jjah0001/Momowo/enclosure/Momowo_Backside.step

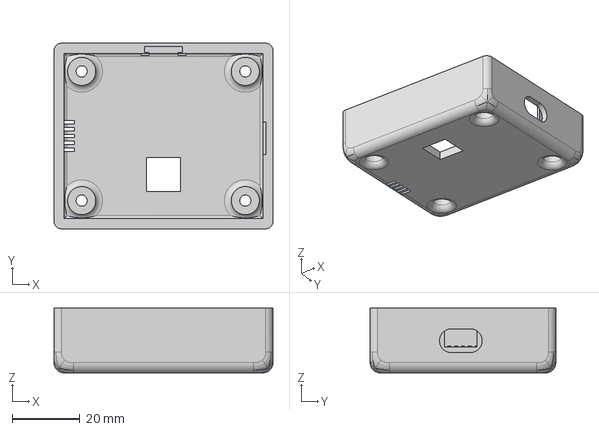
[picture p1: CAD file, 2026-10-25]
enclosure/Momowo_Backside.step
64.6 x 54.7 x 19.1 mm
