jjah0001/Momowo/enclosure/Momowo_Front.step

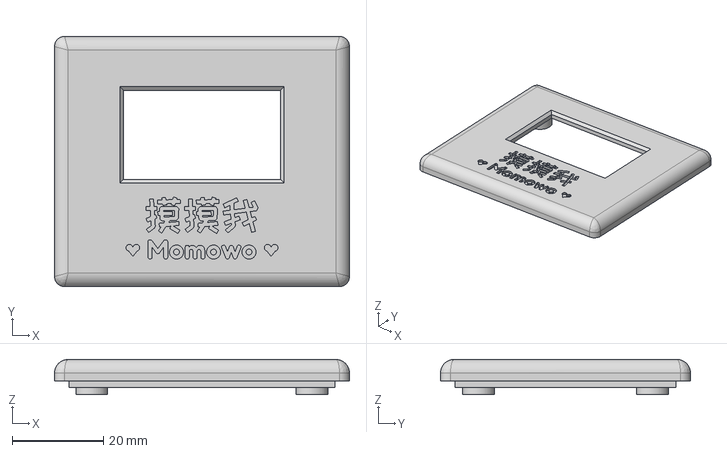
[picture p2: CAD file, 2026-10-25]
enclosure/Momowo_Front.step
64.6 x 54.7 x 7.70 mm
