jjah0001/Momowo/(list of files, cad)

Other CAD files:
enclosure/Momowo_Backside.f3d
enclosure/Momowo_Backside.stl
enclosure/Momowo_Front.f3d
enclosure/Momowo_Front.stl
