jjah0001/Momowo/Momowo_V2.ino

/*
  =====================================================================
   Momowo 摸摸我 ("pat me")  -  ESP32 / ESP32-C3 + TTP223 + SH1106 1.3" OLED + buzzer
  =====================================================================
   An animated desk companion that helps you relax, and also does real work:

     BUDDY    Expressive animated eyes (blinks, looks around, moods, hearts when patted,
              dizzy when shaken) + a ticker: greeting, feelings, time, weather, next prayer
     CLOCK    Big clock, seconds, date; time zone follows where you are
     CALENDAR Gregorian month and the public holidays where you are, plus the calendars you
              choose: Chinese lunar (solar terms, festivals), Islamic (Hijri), Buddhist, Hindu
     WEATHER  Now, tomorrow, the next three days, sunrise and sunset; with the Islamic
              calendar on: prayer times, and imsak / iftar times for fasting
     NEWS     Headlines from any RSS feed; AI reporter sums up the news, can translate it
     QUOTE    Classical Chinese, European or modern quotes; AI translates or explains
     FOCUS    Pomodoro timer with breaks, and a guided breathing exercise
     AI       Optional AI: feelings, translations, summaries, quote meanings
     MOTION   Optional MPU6050: pat or tap the case, shake, tilt, catch a drop
     SOUND    Buzzer: chirps, focus alerts, hourly chime, prayer reminders

   One touch pad does everything:
     tap          -> next page
     double tap   -> back to buddy (he's happy to see you)
     hold ~0.7 s  -> page action (pat buddy / 12-24h / refresh / start-pause)
     hold ~2 s    -> focus page: reset the timer, or start breathing when idle

   Night mode: after SLEEP_HOUR the buddy dozes (Zzz), screen dims, then
   switches off after 10 idle minutes to protect the OLED. Touch wakes it.

   Libraries (Library Manager):
     Adafruit SH110X, Adafruit GFX, ArduinoJson (v7), U8g2_for_Adafruit_GFX
     (the MPU6050 needs no library: motion.h talks to it directly)
   OFFLINE  Works out of the box with no WiFi: buddy, focus timer, clock, calendars and
            built-in classical quotes. Hold the pad 6 s, scan the QR code with a phone,
            and the page that opens sets the clock from the phone (no internet needed)
            and, optionally, WiFi for weather, news and AI.
   RTC      Optional DS3231 clock module on the same I2C pins keeps time through power cuts.
   MOTION   Optional MPU6050 on the same I2C pins. With a DS3231 too, tie the MPU6050's AD0
            pin to 3V3 so it moves to address 0x69.
   Board: ESP32 dev board, or ESP32-C3 SuperMini (pins below switch automatically)
   Tools > Partition Scheme > "Huge APP (3MB No OTA/1MB SPIFFS)". Arduino-ESP32 core 3.x.
   Saved settings are kept when you change partition scheme.
  =====================================================================
*/

#include <WiFi.h>
#include <WiFiClientSecure.h>
#include <HTTPClient.h>
#include <ArduinoJson.h>
#include <Wire.h>
#include <Adafruit_GFX.h>
#include <Adafruit_SH110X.h>
#include <U8g2_for_Adafruit_GFX.h>
#include "font_tc.h"                         // Traditional Chinese font (Fusion Pixel, OFL)
#include <time.h>
#include <math.h>
#include <Preferences.h>
#include <WebServer.h>
#include <DNSServer.h>
#include <ESPmDNS.h>
#include "qrcode.h"                       // Espressif QR encoder (part of core 3.x)
#include "astro.h"                        // sun, moon, prayer times, Hindu calendar
#include "motion.h"                       // MPU6050 driver and gestures
#include "quotes.h"                       // European and modern quotes
#include "games.h"                        // the mini-games page for the phone
#include "font_small.h"                   // tiny 8 px weekday letters for the month grid

// ============================ SETTINGS ===============================
// Owners change these from their phone (setup page); nothing here needs editing.
// The values below are only the starting defaults; saved settings replace them.
static char WIFI_SSID[33]  = "";          // home WiFi (empty = setup mode on first start)
static char WIFI_PASS[65]  = "";
static char WIFI2_SSID[33] = "";          // backup WiFi, e.g. a phone hotspot
static char WIFI2_PASS[65] = "";
static char OWNER_NAME[24] = "";          // used in greetings
static char OWNER_HOBBIES[128] = "";      // owner's hobbies, for more personal AI feelings
static uint8_t OWNER_GENDER = 0;          // 0 not said, 1 male, 2 female, 3 other: for the AI's wording
static uint8_t LANG = 0;                   // Momowo's language (Lang), chosen on the phone page

// Weather location: a suburb or area name, e.g. "Tampines", searched in COUNTRY_CODE.
// Empty = use the IP lookup below (city-level only).
static char SUBURB[64]      = "";
static char COUNTRY_CODE[4] = "SG";

// Location is looked up automatically from your public IP (city-level).
// Set USE_IP_LOCATION = false to always use the fixed spot below instead.
// The fixed spot is also the fallback if the IP lookup keeps failing.
static const bool  USE_IP_LOCATION = true;
static const float FIXED_LAT  = 1.3521f;
static const float FIXED_LON  = 103.8198f;
static const char* FIXED_CITY = "Singapore";

// Timezone is learned automatically (IP lookup + Open-Meteo, DST included).
// This string is only used until the first successful lookup.
static const char* FALLBACK_TZ = "SGT-8";     // Singapore, UTC+8, no daylight saving

static bool USE_24H = true;             // hold on CLOCK page toggles this (remembered)
static const bool HIJRI_AT_SUNSET = false; // true: Islamic date turns over at sunset, not midnight
static int SLEEP_HOUR = 22;             // buddy dozes off (10 pm)
static int WAKE_HOUR  = 7;              // buddy wakes up
static uint8_t FOCUS_MIN = 25;          // Pomodoro length (minutes), set on the phone page
static uint8_t BREAK_MIN = 5;           // short break; every 4th break is three times longer

// Wake-up alarm: up to three alarm times (phone page), plus a nap timer on the Alarm page
#define ALARM_SLOTS 3
struct AlarmSlot { uint8_t h = 7, m = 0, days = 0x3E, on = 0; };   // days: bit 0 Sunday .. bit 6 Saturday, 0 = once
static AlarmSlot ALARMS[ALARM_SLOTS];
static bool    ALARM_ON   = true;       // all alarms on or off (hold on the Alarm page)
static uint8_t SNOOZE_MIN = 9;          // a tap snoozes this long; 0 = no snooze
static uint8_t ALARM_STOP = 0;          // stop by: 0 holding the pad 2 s, 1 shaking Momowo 3 times
static uint8_t NAP_MIN    = 20;         // the nap timer (hold 2 s on the Alarm page)

// Calendars shown beside the Gregorian one (phone page), and what the Islamic one brings
enum : uint8_t { CAL_CHINESE = 1, CAL_ISLAMIC = 2, CAL_BUDDHIST = 4, CAL_HINDU = 8, CAL_JEWISH = 16, CAL_ALL = 31 };
static uint8_t CALS = CAL_CHINESE;
static uint8_t PRAY_METHOD = 255;       // astro::METHODS index; 255 = automatic for the country
static bool    ASR_HANAFI  = false;     // Asr when shadows are twice an object's length
static bool    PRAY_REMIND = true;      // a soft chime and a note at each prayer time

// Quotes: one bit per source, any mix (QKind order): classical Chinese, European, modern,
// Bible, Quran, Torah, Dhammapada, famous people. Momowo takes turns. AI: 0 translate, 1 explain
static uint16_t QUOTE_MASK = 1;
static uint8_t QUOTE_AI  = 0;
static char FAMOUS_PEOPLE[100] = "";    // the owner's own famous people: the AI picks their real quotes

static bool    NEWS_TRANSLATE = false;  // AI translates the headlines into Momowo's language
static uint8_t NEWS_STYLE     = 0;      // AI summary: 0 one sentence, 1 a short news-of-the-day bulletin

static bool    MOTION_ON     = true;    // MPU6050 gestures, if one is fitted
static uint8_t MOTION_SENS   = 2;       // 1 gentle .. 3 sensitive
static bool    MOTION_MIRROR = false;   // eyes look the wrong way when tilted? flip them

// Buzzer on GPIO27. Passive buzzers play tunes; active ones can only beep.
static const bool    BUZZER_PASSIVE   = true;
static uint8_t       NEWS_VOICE       = 0;      // AI news reporter, chosen on the phone page (see VOICES; 6 = own)
static char NEWS_VOICE_OWN[64] = "";       // the owner's own reporter, described on the phone page
static bool          TOUCH_CLICK      = true;   // tiny tick on every touch
static bool          HOURLY_CHIME     = true;   // double beep on the hour, daytime only
static const int QUOTE_MAX_CHARS = 12;    // classical quote length limit (punctuation counts)
static const bool QUOTE_FOLLOWS_CONTEXT = true;   // match season, weather and time of day

// News: any RSS feed. BBC News top stories by default (credited on screen).
static char NEWS_FEED_URL[160] = "https://www.channelnewsasia.com/api/v1/rss-outbound-feed?_format=xml&category=6311";
static char NEWS_CREDIT[32]     = "CNA";

// Optional AI: one active provider, with independent saved keys and model overrides.
// Provider 0 preserves existing Claude settings and the legacy "aikey" preference.
static uint8_t AI_PROVIDER = 0;
static char AI_API_KEY[512] = "";
static char AI_MODEL_CUSTOM[96] = "";
static const char* const AI_KEY_PREFS[] = {"aikey", "openai_key", "kimi_key", "deepseek_key"};
static const char* const AI_MODEL_PREFS[] = {"claude_model", "openai_model", "kimi_model", "deepseek_model"};
static const char* const AI_DEFAULT_MODELS[] = {"", "gpt-4.1-mini", "kimi-k2.6", "deepseek-flash"};
static const char* const AI_ENDPOINTS[] = {
  "https://api.anthropic.com/v1/messages",
  "https://api.openai.com/v1/chat/completions",
  "https://api.moonshot.ai/v1/chat/completions",
  "https://api.deepseek.com/chat/completions"
};
// Model and effort are chosen on the phone page. Smarter models and more effort cost more and take longer.
static const char* const AI_MODELS[4]  = {"claude-haiku-5-5", "claude-sonnet-5-5", "claude-opus-5-5", "claude-fable-5-1"};
static const char* const AI_EFFORTS[5] = {"low", "medium", "high", "xhigh", "max"};
static const int         AI_THINK_ROOM[5] = {2000, 4000, 8000, 16000, 32000};   // tokens for thinking, on top of the reply
static uint8_t     AI_MODEL_IX          = 0;     // Haiku
static uint8_t     AI_EFFORT_IX         = 0;     // low: short texts don't need long thinking
static uint16_t    AI_DAY_LIMIT         = 100;   // safety cap on cost: requests a day, chosen on the phone page
static volatile uint16_t gAiUsed        = 0;     // today's requests, kept in flash so a restart doesn't reset them
static int16_t     gAiDay               = -1;    // the day they were counted (day of the year)
static uint16_t    FEEL_MIN             = 90;    // with AI: a feeling of its own every this many minutes (0 = off), chosen on the phone page
#define AI_FEELINGS (FEEL_MIN > 0)

// The AI reply arrives streamed (server-sent events). Streaming keeps the connection busy while the
// model thinks, so high effort doesn't time out; only the reply's text is kept.
class SseSink : public Stream {
 public:
  SseSink(char* o, size_t n) : out(o), outSz(n) { out[0] = 0; }
  char* out;
  size_t outSz, len = 0;
  char stop[20] = "";                       // stop_reason: end_turn, max_tokens, refusal...
  bool error = false;
  size_t write(uint8_t c) override {
    if (c == '\n') {
      if (!skip) { line[ll] = 0; take(); }
      ll = 0;
      skip = false;
    } else if (c != '\r') {
      if (ll + 1 < sizeof(line)) line[ll++] = c;
      else {
        line[ll] = 0;
        skip = true;
        // Claude signatures/thinking can exceed the line buffer; no display text is lost.
        if (!strstr(line, "\"signature_delta\"") && !strstr(line, "\"thinking_delta\"")) error = true;
      }
    }
    return 1;
  }
  size_t write(const uint8_t* b, size_t n) override { for (size_t i = 0; i < n; i++) write(b[i]); return n; }
  int available() override { return 0; }
  int read() override { return -1; }
  int peek() override { return -1; }
  void flush() override {}
 private:
  char line[1024];
  size_t ll = 0;
  bool skip = false;
  void take() {
    if (strncmp(line, "data:", 5)) return;
    const char* j = line + 5;
    while (*j == ' ') ++j;
    if (!strcmp(j, "[DONE]")) return;
    JsonDocument d;
    if (deserializeJson(d, j)) { error = true; return; }
    const char* type = d["type"] | "";
    if (!strcmp(type, "error") || !d["error"].isNull()) { error = true; return; }
    const char* text = "";
    if (!strcmp(type, "content_block_delta") &&
        !strcmp(d["delta"]["type"] | "", "text_delta")) text = d["delta"]["text"] | "";
    if (!strcmp(type, "message_delta"))
      strlcpy(stop, d["delta"]["stop_reason"] | "", sizeof(stop));
    if (d["choices"].is<JsonArray>() && d["choices"].size()) {
      text = d["choices"][0]["delta"]["content"] | "";
      if (!d["choices"][0]["delta"]["refusal"].isNull()) error = true;
      if (d["choices"][0]["finish_reason"].is<const char*>())
        strlcpy(stop, d["choices"][0]["finish_reason"], sizeof(stop));
    }
    size_t n = strlen(text);
    if (n >= outSz - len) n = outSz - 1 - len;
    memcpy(out + len, text, n);
    len += n;
    out[len] = 0;
  }
};

// ============================ HARDWARE ===============================
#if CONFIG_IDF_TARGET_ESP32C3    // ESP32-C3 SuperMini: matches PCB: SDA GPIO9, SCL GPIO8 (both strapping pins)
#define TOUCH_PIN  3
#define BUZZER_PIN 4
#define OLED_SDA   9
#define OLED_SCL   8
#else                            // classic ESP32 dev board
#define TOUCH_PIN  12    // NOTE: GPIO12 is a boot strapping pin, must be LOW at power-up
#define BUZZER_PIN 27
#define OLED_SDA   21
#define OLED_SCL   22
#endif

#if CONFIG_FREERTOS_UNICORE      // single-core chips (ESP32-C3): everything on core 0
#define NET_CORE 0
#define SND_CORE 0
#else                            // dual-core ESP32: network on core 0, sound beside loop()
#define NET_CORE 0
#define SND_CORE 1
#endif
#define OLED_ADDR  0x3C
#define SCREEN_W   128
#define SCREEN_H   64

Adafruit_SH1106G display(SCREEN_W, SCREEN_H, &Wire, -1);

static const uint8_t CONTRAST_DAY   = 0x80;   // 0x00-0xFF
static const uint8_t CONTRAST_NIGHT = 0x01;   // dimmed while buddy sleeps
static const uint8_t CONTRAST_IDLE  = 0x20;   // daytime, nobody near for 20 min (saves the OLED)
static const uint8_t CONTRAST_QR    = 0x30;   // setup QR code: a dimmer white square doesn't glare in phone cameras

U8G2_FOR_ADAFRUIT_GFX u8f;                    // draws UTF-8 Chinese into the same buffer
// One 14 px subset font (common GB2312 hanzi) for the quote and its source,
// so the sketch fits the default partition scheme on ESP32 core 3.x. Quotes
// using a character outside it are skipped, so nothing shows as a gap.
// With Tools > Partition Scheme > Huge APP you could use larger, full fonts,
// e.g. u8g2_font_wqy16_t_gb2312 for the quote and wqy12_t_gb2312 for the source.
#define CJK_FONT     u8g2_font_wqy14_t_gb2312b  // quote source line
#define CJK_FONT_BIG u8g2_font_wqy14_t_gb2312b  // the quote itself

#define DEG "\xF8"   // degree symbol in CP437 font

// ============================ TIMING =================================
static const uint32_t FRAME_MS         = 33;              // ~30 fps
static const uint32_t LONG_MS          = 700;
static const uint32_t VLONG_MS         = 2000;
static const uint32_t SETUP_HOLD_MS    = 6000;   // hold this long anywhere: setup mode
static const uint32_t DOUBLE_GAP_MS    = 300;
static const uint32_t IDLE_HOME_MS     = 90000;           // return to buddy
static const uint32_t WEATHER_EVERY_MS = 15UL * 60 * 1000;
static const uint32_t GEO_EVERY_MS     = 6UL * 60 * 60 * 1000;   // re-check if you travel
static const uint32_t HOME_CHECK_MS    = 10UL * 60 * 1000;       // on hotspot: look for home WiFi
static const uint32_t QUOTE_MIN_GAP_MS = 30UL * 60 * 1000;       // context change -> new quote, at most this often
static const uint32_t NEWS_EVERY_MS    = 30UL * 60 * 1000;       // headlines refresh
static const uint32_t BRIEF_EVERY_MS   = 2UL * 60 * 60 * 1000;   // AI news briefing refresh
#define FEEL_EVERY_MS ((uint32_t)FEEL_MIN * 60000UL)                   // AI feeling, waking hours only
static const uint32_t NIGHT_OFF_MS     = 10UL * 60 * 1000;
#define focusMs() (FOCUS_MIN * 60UL * 1000)   // a macro: a function here would come before the types below

// ============================ SHARED DATA ============================
struct WeatherData {
  bool valid = false;
  uint32_t at = 0;                          // millis() when it was fetched
  float temp = 0, feels = 0, tmax = 0, tmin = 0, wind = 0;
  int humidity = 0, code = 0, rainChance = 0;
  bool isDay = true;
  int sunriseMin = -1, sunsetMin = -1;      // today, minutes after midnight
  int tmSunrise = -1, tmSunset = -1;        // tomorrow
  bool tmValid = false;     // tomorrow's forecast
  float tmMax = 0, tmMin = 0, tmWind = 0;
  int tmCode = 0, tmRain = 0;
  uint8_t days = 0;         // daily forecast: 0 today, 1 tomorrow, 2-4 the next three days
  int8_t dMax[5], dMin[5];
  uint8_t dCode[5], dRain[5];
  int aqi = -1;             // US Air Quality Index now (-1 unknown), and particles in ug/m3
  float pm25 = -1, pm10 = -1;
};

enum QKind : uint8_t { Q_CHINESE, Q_EUROPE, Q_MODERN, Q_BIBLE, Q_QURAN, Q_TORAH, Q_DHAMMA, Q_FAMOUS, Q_KINDS };
struct QuoteData {
  QKind kind = Q_CHINESE;
  char text[256] = "";      // raw UTF-8, in the original language
  char author[96] = "";
  char tag[8] = "";         // theme shown beside the source, e.g. "雨"
  char meaning[320] = "";   // meaning, translation or explanation (AI or built-in), UTF-8
  int8_t lang = -1;         // famous people: the quote's language (Lang), -1 another one
  uint32_t version = 0;
};

#define NEWS_MAX 8
struct NewsData {
  uint8_t count = 0;
  char title[NEWS_MAX][120];   // headlines, UTF-8 (translated by the AI if asked)
  char brief[640] = "";        // AI briefing: one sentence, or a short bulletin
  uint32_t version = 0;
};

struct LocationData {
  bool valid = false;
  float lat = 0, lon = 0;
  char city[40] = "";                       // English (plain ASCII): for the AI prompts
  char name[64] = "";                       // in the chosen language (UTF-8): shown on screen
};

static WeatherData gWeather;
static QuoteData gQuote;
static LocationData gLoc;

struct CalInfo {                            // today's date in the three calendars
  bool valid = false;
  bool lunarOk = false, leap = false, eve = false;   // eve = Chinese New Year's Eve
  int ly = 0, lm = 0, ld = 0;               // Chinese lunar year / month / day
  int termToday = -1, termNext = -1, termDays = 0;   // solar terms
  int be = 0;                               // Buddhist year (Indonesian: new year at Waisak)
  bool waisak = false;
  const char* christian = nullptr;          // Christmas / Easter day name, English
  int hy = 0, hm = 0, hd = 0;               // Hijri year / month / day
  int wday = 0;
  bool hinduOk = false;                     // Hindu calendar (needs a location for sunrise)
  astro::Panchang pj;
  const char* hinduFest = nullptr;
  bool hebOk = false;                       // Hebrew date (from sunset), festival, Shabbat
  int32_t hebY = 0;
  int hebM = 0, hebD = 0, hebFestN = 0;
  astro::HebFest hebFest = astro::HF_NONE;
  int candles = -1;                         // Friday: Shabbat candle lighting, minutes after midnight
  bool shabbat = false;
  char holToday[48] = "";                   // today's public holiday, if any
  char holNext[48] = "";                    // the next one this year, in holDays days
  int holDays = -1;
  uint32_t holMask = 0;                     // bit d: day d of this month is a public holiday
};

struct PrayerDay {                          // today's prayer times, minutes after midnight
  bool valid = false;
  int key = -1;
  float t[astro::PRAYER_COUNT];
  float tmFajr = NAN;                       // tomorrow's, for the evening countdown
};

struct LunarDay { uint8_t m, d; const char* label; const char* greeting; };
struct Note { uint16_t hz; uint16_t ms; };       // hz 0 = rest

static CalInfo gCal;

// Public holidays in the country Momowo is in (Nager.Date), nationwide ones only.
// Written by the network task, kept through restarts.
struct Holiday { uint8_t m, d; char name[48]; };
static const int HOL_MAX = 28;
static Holiday gHol[HOL_MAX];
static uint8_t gHolCount = 0;
static int16_t gHolYear = 0;
static char gHolCC[4] = "";
static uint8_t gHolLang = 255;
static volatile uint16_t gHolVersion = 0;
static char gHolGreet[96];
static char gHebGreet[96];
static int8_t gHijriAdj = 0;                // -1, 0, +1 days (hold on CALENDAR)
static bool gMuted = false;                 // set on the phone settings page (remembered)
static Preferences prefs;
static SemaphoreHandle_t gMutex;
static SemaphoreHandle_t gScanMutex;        // one WiFi scan at a time: both cores share the scan list
static volatile bool gWifiUp = false;
static volatile bool gOnHotspot = false;   // on the backup network
static volatile bool gEverOnline = false;
static volatile bool gSetupMode = false;   // Momowo's own WiFi + setup page
static volatile uint8_t gWifiReason = 0;   // why the last WiFi connection failed (0 = fine)
static bool gSetupAuto = false;            // opened because home WiFi kept failing
static char gApSsid[16], gApPass[12];
static char gHost[20] = "momowo";          // unique per unit, e.g. momowo-a1b2 (many units, one network)
static uint32_t gSetupAt = 0;              // when setup mode opened
static float gSavedLat = NAN;              // last known latitude, for seasons while offline
static float gSavedLon = NAN;              // and longitude, for prayer times offline
static PrayerDay gPray;
static uint8_t gBreaks = 0;                 // breaks taken this session run, for the long break
static bool gMotion = false;                // MPU6050 found
static motion::State gMs;
static int gShakesToday = 0, gBreathsToday = 0;
static char gCountryCode[4] = "";           // from the IP lookup, e.g. "SG" (picks the prayer method)
static bool gRtc = false;                  // DS3231 clock module found
static volatile uint32_t gRestartAt = 0;
static volatile uint32_t gNetAlive = 0;     // netTask's last pass
static volatile bool gRestartSoon = false;  // memory is getting fragmented: restart when nobody's looking
static WebServer server(80);
static DNSServer dnsServer;
static volatile bool gReqWeather = false;
static volatile bool gReqQuote = false;
static volatile bool gReqNews = false;
static NewsData gNews;

// Timezone learned from the network (seconds east of UTC); loop() applies it
static volatile int32_t  gTzOffset  = 0;
static volatile bool     gTzKnown   = false;
static volatile uint32_t gTzVersion = 0;
static char gTzRule[48] = "";               // the phone's time zone with its summer-time rule (POSIX TZ), if any
static volatile bool gTzRuleOn = false;      // that rule sets the offset (loop() checks it)
static volatile int32_t gTzSaid = 0;         // the offset the network last reported
static volatile uint32_t gTzSaidVer = 0;

// ============================ UI STATE ===============================
enum Page : uint8_t { P_BUDDY, P_CLOCK, P_CAL, P_WEATHER, P_NEWS, P_QUOTE, P_FOCUS, P_ALARM, P_COUNT };
enum Lang : uint8_t { L_EN, L_ZHS, L_ZHT, L_ID, L_DE, L_FR, L_JA, L_ES, L_COUNT };   // phone page order
#include "lang.h"                           // screen labels in all eight languages: T(S_...)
struct BuddhistDay { uint8_t m, d; Str name; };
enum Mood : uint8_t { M_NORMAL, M_HAPPY, M_SLEEPY, M_SURPRISED, M_LOVE, M_SAD, M_DIZZY };

struct Feeling {                            // Momowo's own feeling (AI), guarded by gMutex
  bool valid = false;
  Mood mood = M_NORMAL;
  char thought[160] = "";                   // first person, UTF-8
  char pats[3][64];                         // replies to a pat while feeling this way
  uint8_t patCount = 0;
  uint32_t version = 0;
};
static Feeling gFeel;
static int gPatsToday = 0;                    // kept in flash with the focus count's date
static uint32_t gFeelSavedAt = 0, gBriefSavedAt = 0;   // when a restored feeling / briefing was made
static int gQuoteRestoredKey = -3;            // context of a quote restored at start-up (-3: none)
enum FocusState : uint8_t { F_IDLE, F_RUN, F_PAUSE, F_BREAK, F_BREATHE };   // break and breathing count down too
enum Gesture : uint8_t { G_NONE, G_TAP, G_DOUBLE, G_LONG, G_VLONG, G_SETUP, G_HINT };
enum WIcon : uint8_t { W_CLEAR, W_PARTLY, W_CLOUD, W_FOG, W_DRIZZLE, W_RAIN, W_SNOW, W_STORM };
enum QTheme : uint8_t { T_SPRING, T_SUMMER, T_AUTUMN, T_WINTER, T_RAIN, T_SNOW, T_CLOUD, T_WIND,
                        T_SUN, T_MOON, T_STARS, T_NONE };
// One line of the "today in each calendar" view. lunar: drawn in the Chinese lunar font.
struct CalRow { char text[72]; char alt[72]; bool lunar; };
struct LocalQuote { QTheme theme; const char* text; const char* who; const char* from; const char* meaning; };
// 今日诗词 v1 category for each quote theme, and the tag shown beside the source
static const char* const THEME_PATH[] = {
  "siji/chuntian", "siji/xiatian", "siji/qiutian", "siji/dongtian",
  "tianqi/xieyu", "tianqi/xiexue", "tianqi/xieyun", "tianqi/xiefeng",
  "tianqi/taiyang", "tianqi/yueliang", "tianqi/xingxing"};
static const char* const THEME_TAG[] = {"春", "夏", "秋", "冬", "雨", "雪", "云", "风", "日", "月", "星"};
// The alarm while it rings, snoozes or times a nap
enum : uint8_t { AL_IDLE, AL_RING, AL_SNOOZE };
struct AlarmNote { uint16_t hz; uint8_t steps; };   // steps: eighth notes
struct AlarmRun {
  uint8_t state = AL_IDLE;
  bool nap = false;                         // this ring ends a nap
  uint8_t h = 0, m = 0;                     // the alarm time it rings for
  uint8_t snoozes = 0, shakes = 0;
  uint32_t ringAt = 0;                      // when this round of ringing began
  uint32_t snoozeUntil = 0, napUntil = 0, napTotal = 0;
  uint32_t pressSeen = 0;                   // a pad press the alarm already used: its gestures are ignored
  uint32_t lastMin = 0;                     // the last minute checked (minutes since 1970)
};
// NOTE: keep every custom type up here. The Arduino IDE inserts function
// prototypes above the first function, so types declared later break them.

static Page gPage = P_BUDDY;
static uint32_t gPageEnter = 0, gLastInteraction = 0, gNightAwakeUntil = 0, gFlashUntil = 0;
static uint32_t gLoopNow = 0;                 // loop()'s "now", for the web handlers it calls
static bool gNight = false, gSleeping = false, gDisplayOn = true, gInverted = false;
static char gAiStatus[64] = "";             // why the last AI request failed, shown on the ticker
static char gNewsStatus[96] = "";           // why the news is missing, shown on the News page

static char gToast[32];
static uint32_t gToastUntil = 0;
static char gTicker[160];                  // big enough for a whole AI feeling, in any language
static uint32_t gTickerStart = 0, gTickerUntil = 0;

static AlarmRun gAlarm;
static volatile uint8_t  gAlarmLevel = 0;   // for the sound task: 0 quiet, 1-3 how insistently the alarm plays
static volatile uint16_t gBuzzDuty = 511;   // buzzer PWM duty (the alarm starts softly)
static FocusState fState = F_IDLE;
static uint32_t fRemain = 25 * 60000UL, fLastTick = 0, fTotal = 25 * 60000UL;   // fTotal: this phase's length
static int gSessions = 0, gSessionDay = -1;  // today's focus sessions and their date (year*1000+day),
                                             // kept in flash so a restart or settings change keeps them

struct Buddy {
  float gx = 0, gy = 0, tgx = 0, tgy = 0;   // gaze (current / target)
  float h = 26;                             // eye height
  uint32_t nextGaze = 0, nextBlink = 0, blinkAt = 0, nextAntic = 0;
  bool doubleBlink = false;
  Mood ov = M_NORMAL;                       // temporary mood override
  uint32_t ovUntil = 0;
  uint32_t heartsAt = 0;                    // little hearts float up after a pat
} B;

// Mini-games, played on the phone page while Momowo plays along on its screen
enum : uint8_t { GM_NONE, GM_RPS, GM_TTT, GM_GUESS, GM_SIMON, GM_ROLL, GM_RIDDLE, GM_QUEST, GM_TAP };
enum : uint8_t { RD_NONE, RD_THINKING, RD_ASKING, RD_JUDGING, RD_SOLVED, RD_REVEALED, RD_FAILED };
enum : uint8_t { QS_NONE, QS_THINKING, QS_READY, QS_STEP, QS_DONE };          // quest phases
enum : uint8_t { TP_IDLE, TP_WAIT, TP_GO, TP_SHOW, TP_DONE };                 // quick tap phases
#define TAP_ROUNDS 5
enum : uint8_t { QA_TAP, QA_HOLD, QA_LEFT, QA_RIGHT, QA_UP, QA_DOWN, QA_SHAKE, QA_COUNT };   // quest actions
#define QUEST_MAX 8
struct Game {
  uint8_t game = GM_NONE;
  uint32_t last = 0, at = 0;                // the phone's last move; when the current show began
  uint32_t rAt = 0;                         // when the riddle text started (its own: the AI answers any time)
  Mood mood = M_NORMAL;                     // Momowo's reaction, until moodUntil
  uint32_t moodUntil = 0;
  Str say = S_GM_YOUR_TURN;                 // what Momowo says (with sayArg for a %d)
  int sayArg = 0;
  bool sounded = true;                      // the reveal sound has played
  int8_t you = -1, me = -1, result = 0;     // rock paper scissors: 0 rock, 1 paper, 2 scissors;
  uint16_t wins = 0, losses = 0;            // result 0 draw, 1 you win, 2 Momowo wins
  uint8_t board[9] = {};                    // tic-tac-toe: 0 empty, 1 you, 2 Momowo
  uint8_t over = 0, lastMove = 255;         // 0 playing, 1 you won, 2 Momowo won, 3 draw
  uint8_t secret = 0, tries = 0, guess = 0; // guess my number
  int8_t hint = 0;                          // 1 higher, -1 lower, 2 right
  uint8_t seq[40] = {}, len = 0, pos = 0, best = 0;   // memory: arrows up, right, down, left
  bool showing = false;
  uint8_t shown = 255, pressed = 255;       // the arrow lit by the show, and by the owner
  uint32_t pressedAt = 0;
  // star roll: tilt Momowo to roll the ball onto the stars (pixels, pixels per second)
  float bx = 64, by = 40, vx = 0, vy = 0, cx = 20, cy = 30, cvx = 16, cvy = 9;
  int16_t sx = 0, sy = 0;
  uint16_t stars = 0, bestStars = 0;
  bool rolling = false, newBest = false;
  uint32_t startAt = 0, endAt = 0, tickAt = 0, hurtAt = 0, starAt = 0;
  // riddles: the AI makes one up and judges guesses that don't match its answer exactly
  uint8_t rphase = RD_NONE, rtries = 0;
  bool rhint = false;
  char riddle[240] = "", answer[48] = "", alts[160] = "", hintText[120] = "", rguess[48] = "";
  // quest: the AI tells a little adventure; each moment asks for a tap, a hold, a tilt or a shake
  uint8_t qphase = QS_NONE, qn = 0, qstep = 0, qhearts = 0, qscore = 0, qbest = 0;
  uint8_t qact[QUEST_MAX] = {};
  bool qwon = false, qnewBest = false, qarmed = false, qok = false, qstory = false;
  uint32_t qreadyAt = 0, qstepAt = 0, qwin = 0, qwaitUntil = 0;
  float holdRef[3] = {0, 0, 1};             // star roll, quest: how the player holds Momowo; tilts count from here
  char qtitle[64] = "", qtext[QUEST_MAX][100] = {}, qend[2][120] = {};   // ending: 0 won, 1 lost
  // quick tap: wait for the flash and the beep, then tap the pad; the average of 5 rounds counts
  uint8_t tphase = TP_IDLE, tround = 0;
  int16_t tlast = 0;                        // last round: ms, -1 too soon, -2 too slow
  uint16_t tms[TAP_ROUNDS] = {}, tavg = 0, tbest = 0;   // best: lowest average, ms
  bool tnewBest = false;
  uint32_t tgoAt = 0, tfakeAt = 0, tshowUntil = 0, tseen = 0;
} gGame;
static bool gAiForUser = false;            // netTask: this AI request was asked for just now (riddles)
static volatile uint8_t gRiddleReq = 0;     // for netTask: 1 make a riddle, 2 judge the guess
static volatile bool gQuestReq = false;     // for netTask: write a quest story
static uint32_t gTouchPressAt = 0;          // when the finger last went down on the pad
static uint32_t gLastTouch = 0;             // the pad was last touched (its bumps are not pats)

// ============================ HELPERS ================================
static bool nowTm(struct tm& t) {
  time_t n = time(nullptr);
  if (n < 1700000000) return false;         // not synced yet
  localtime_r(&n, &t);
  return true;
}

static bool isNightHour(int h) {
  return SLEEP_HOUR > WAKE_HOUR ? (h >= SLEEP_HOUR || h < WAKE_HOUR)
                                : (h >= SLEEP_HOUR && h < WAKE_HOUR);
}

// Language names for the AI, and the words Momowo says itself (same order as Lang)
static const char* const LANG_NAME[L_COUNT] = {"English", "Simplified Chinese", "Traditional Chinese",
  "Indonesian", "German", "French", "Japanese", "Spanish"};
static const char* const GREET[L_COUNT][4] = {      // night, morning, afternoon, evening
  {"Good night", "Good morning", "Good afternoon", "Good evening"},
  {"晚安", "早上好", "下午好", "晚上好"},
  {"晚安", "早安", "午安", "晚上好"},
  {"Selamat malam", "Selamat pagi", "Selamat siang", "Selamat malam"},
  {"Gute Nacht", "Guten Morgen", "Guten Tag", "Guten Abend"},
  {"Bonne nuit", "Bonjour", "Bon après-midi", "Bonsoir"},
  {"おやすみ", "おはよう", "こんにちは", "こんばんは"},
  {"Buenas noches", "Buenos días", "Buenas tardes", "Buenas tardes"}};
static const char* const THINKING[L_COUNT] = {"Let me think how I feel...", "让我想想现在的心情…",
  "讓我想想現在的心情…", "Sebentar, aku pikir dulu...", "Moment, wie fühle ich mich?",
  "Voyons, comment je me sens...", "今の気持ちを考え中…", "Déjame pensar cómo me siento..."};

static bool langIsCjk() { return LANG == L_ZHS || LANG == L_ZHT || LANG == L_JA; }

static const char* greetingFor(int h) {
  const char* const* g = GREET[LANG < L_COUNT ? LANG : 0];
  if (h < 5)  return g[0];
  if (h < 12) return g[1];
  if (h < 17) return g[2];
  if (h < 21) return g[3];
  return g[0];
}

// Weekday and date in the chosen language, e.g. "Tuesday, 6 October", "10月6日 星期二", "10月6日(火)".
// longMonth: try the full month name first, falling back to the short one if it doesn't fit.
static void fmtDate(const struct tm& t, char* out, size_t n, bool longMonth) {
  const char* wd = WEEKDAY[LANG][t.tm_wday];
  int m = t.tm_mon, d = t.tm_mday;
  if (LANG == L_ZHS || LANG == L_ZHT) { snprintf(out, n, "%d月%d日 %s", m + 1, d, wd); return; }
  if (LANG == L_JA) { snprintf(out, n, "%d月%d日(%s)", m + 1, d, wd); return; }
  for (int pass = longMonth ? 0 : 1; pass < 2; pass++) {
    const char* mon = (pass == 0 ? MONTH_LONG : MONTH_SHORT)[LANG][m];
    if (LANG == L_DE)      snprintf(out, n, "%s, %d. %s", wd, d, mon);
    else if (LANG == L_FR) snprintf(out, n, "%s %d %s", wd, d, mon);
    else if (LANG == L_ES) snprintf(out, n, pass == 0 ? "%s, %d de %s" : "%s, %d %s", wd, d, mon);
    else                   snprintf(out, n, "%s, %d %s", wd, d, mon);   // English, Indonesian
    if (pass == 1 || textWidthPx(out) <= SCREEN_W) return;
  }
}

// "Good morning, Jeffrey!" in the right style for the language
static void greetingLine(int h, char* out, size_t n) {
  const char* g = greetingFor(h);
  if (!OWNER_NAME[0]) snprintf(out, n, langIsCjk() ? "%s！" : "%s!", g);
  else if (LANG == L_JA) snprintf(out, n, "%s、%sさん！", g, OWNER_NAME);
  else if (langIsCjk()) snprintf(out, n, "%s，%s！", g, OWNER_NAME);
  else snprintf(out, n, "%s, %s!", g, OWNER_NAME);
}

static void fmtMinutes(int mins, char* out, size_t n) {   // minutes after midnight
  if (mins < 0 || mins >= 24 * 60) { snprintf(out, n, "--:--"); return; }
  int h = mins / 60, m = mins % 60;
  if (USE_24H) snprintf(out, n, "%02d:%02d", h, m);
  else snprintf(out, n, "%d:%02d%s", h % 12 ? h % 12 : 12, m, h < 12 ? "am" : "pm");
}

static void fmtTime(const struct tm& t, char* out, size_t n) {
  if (USE_24H) strftime(out, n, "%H:%M", &t);
  else {
    int h = t.tm_hour % 12;
    if (!h) h = 12;
    snprintf(out, n, "%d:%02d", h, t.tm_min);
  }
}

// UTF-8 -> plain ASCII the OLED font can show (smart quotes, dashes, accents)
static void asciiize(const char* in, char* out, size_t outSz) {
  static const char LATIN1[] =
    "AAAAAAACEEEEIIIIDNOOOOOxOUUUUYPsaaaaaaaceeeeiiiidnooooo/ouuuuypy";
  const uint8_t* p = (const uint8_t*)in;
  size_t o = 0;
  while (*p && o + 4 < outSz) {
    uint8_t c = *p;
    if (c < 0x80) {
      out[o++] = (c == '\n' || c == '\r' || c == '\t') ? ' ' : (char)c;
      p++;
      continue;
    }
    if (c == 0xC3 && p[1] >= 0x80 && p[1] <= 0xBF) {
      out[o++] = LATIN1[p[1] - 0x80];
      p += 2;
      continue;
    }
    if (c == 0xE2 && p[1] == 0x80 && p[2]) {
      switch (p[2]) {
        case 0x98: case 0x99: out[o++] = '\''; break;
        case 0x9C: case 0x9D: out[o++] = '"';  break;
        case 0x93: case 0x94: out[o++] = '-';  break;
        case 0xA6: out[o++] = '.'; out[o++] = '.'; out[o++] = '.'; break;
        default: break;
      }
      p += 3;
      continue;
    }
    p++;
    while ((*p & 0xC0) == 0x80) p++;        // skip unsupported multibyte char
  }
  out[o] = 0;
}

static int utf8Count(const char* s) {        // characters, not bytes
  int n = 0;
  for (; *s; s++)
    if (((uint8_t)*s & 0xC0) != 0x80) n++;
  return n;
}

static void setQuote(const char* q, const char* a, const char* tag) {
  xSemaphoreTake(gMutex, portMAX_DELAY);
  size_t o = 0;                             // copy without line breaks
  for (const char* c = q; *c && o + 1 < sizeof(gQuote.text); c++)
    if (*c != '\n' && *c != '\r') gQuote.text[o++] = *c;
  gQuote.text[o] = 0;
  strlcpy(gQuote.author, a, sizeof(gQuote.author));
  strlcpy(gQuote.tag, tag, sizeof(gQuote.tag));
  gQuote.kind = Q_CHINESE;
  gQuote.meaning[0] = 0;                    // a new quote needs a new meaning
  gQuote.version++;
  xSemaphoreGive(gMutex);
}

static LocationData getLocation() {
  LocationData l;
  xSemaphoreTake(gMutex, portMAX_DELAY);
  l = gLoc;
  xSemaphoreGive(gMutex);
  return l;
}

static void setTzOffset(int32_t off) {
  if (!gTzKnown || off != gTzOffset) {
    gTzOffset = off;
    gTzKnown = true;
    gTzVersion = gTzVersion + 1;
    if (prefs.getInt("tzoff", INT32_MIN) != off) prefs.putInt("tzoff", off);   // remembered offline
  }
}

// An offset from the network (weather, location). With a saved zone rule, loop() checks it against the rule.
static void netTzOffset(int32_t off) {
  gTzSaid = off;
  gTzSaidVer = gTzSaidVer + 1;
  if (!gTzRuleOn) setTzOffset(off);
}

static int32_t tzEastAt(time_t t) {         // seconds east of UTC at t, by the TZ in force
  struct tm l, g;
  localtime_r(&t, &l);
  gmtime_r(&t, &g);
  int dd = l.tm_year != g.tm_year ? (l.tm_year > g.tm_year ? 1 : -1) : l.tm_yday - g.tm_yday;
  return dd * 86400 + (l.tm_hour - g.tm_hour) * 3600 + (l.tm_min - g.tm_min) * 60 + (l.tm_sec - g.tm_sec);
}

// loop() only: the saved zone rule, which follows summer time even with no network, or else
// seconds-east-of-UTC as a fixed POSIX TZ string (sign is inverted there). force: TZ was reset.
static void applyTimezone(bool force) {
  static char applied[48] = "";
  static uint32_t seenSaid = 0, missSince = 0;
  const time_t now = time(nullptr);
  const bool report = gTzSaidVer != seenSaid;
  seenSaid = gTzSaidVer;
  if (gTzRule[0] && gTzKnown && now > 1700000000) {
    if (force || strcmp(applied, gTzRule)) {
      strlcpy(applied, gTzRule, sizeof(applied));
      setenv("TZ", applied, 1);
      tzset();
    }
    const int32_t east = tzEastAt(now);
    bool drop = false;
    if (report) {
      const int32_t said = gTzSaid;
      if (said == east) missSince = 0;
      else if (said != tzEastAt(now + 182 * 86400L)) drop = true;   // neither of this zone's offsets: moved
      else if (!missSince) missSince = millis() | 1;   // its other one: a report from just before a change?
    }
    if (missSince && millis() - missSince > 26 * 3600000UL) drop = true;   // no: a zone with other dates
    if (!drop) {
      gTzRuleOn = true;
      if (east != gTzOffset) setTzOffset(east);   // summer time began or ended
      return;
    }
    gTzRule[0] = 0;
    prefs.remove("tzrule");
    Serial.println("[clock] the network disagrees with the phone's time zone: rule dropped");
    if (gTzSaidVer) setTzOffset(gTzSaid);
  }
  gTzRuleOn = false;
  missSince = 0;
  char tz[20];
  if (!gTzKnown) {
    strlcpy(tz, FALLBACK_TZ, sizeof(tz));
  } else {
    int32_t off = gTzOffset;
    int32_t a = off < 0 ? -off : off;
    if (a % 3600) snprintf(tz, sizeof(tz), "UTC%c%d:%02d", off >= 0 ? '-' : '+', (int)(a / 3600), (int)(a % 3600 / 60));
    else          snprintf(tz, sizeof(tz), "UTC%c%d", off >= 0 ? '-' : '+', (int)(a / 3600));
  }
  if (force || strcmp(applied, tz)) {
    strlcpy(applied, tz, sizeof(applied));
    setenv("TZ", applied, 1);
    tzset();
  }
}

static WeatherData getWeather() {
  static WeatherData cache;
  if (xSemaphoreTake(gMutex, pdMS_TO_TICKS(5)) == pdTRUE) {
    cache = gWeather;
    xSemaphoreGive(gMutex);
  }
  if (cache.valid && millis() - cache.at > 3UL * 3600000) {   // offline for 3 h: don't show it as "now"
    WeatherData old;                        // (sunrise/sunset then come from the calculation)
    return old;
  }
  return cache;
}

// ============================ CALENDARS ==============================
// Chinese lunar calendar 2000-2100, generated from astronomical new moons and
// solar terms (China Standard Time), checked day by day against an independent
// implementation. Per year: bits 0-12 month lengths in order (1 = 30 days, leap
// month included), bits 13-16 leap month follows month N (0 = none), bits 17-22
// day of year of Chinese New Year (0 = 1 Jan).
static const uint32_t LUNAR_INFO[101] = {
  0x460693, 0x2e952b, 0x54052b, 0x3e0a5b, 0x2a555a, 0x4e056a, 0x38fb55, 0x600ba4,
  0x4a0b49, 0x32ba93, 0x580a95, 0x42052d, 0x2c8aad, 0x500ab5, 0x3d35aa, 0x6205d2,
  0x4c0da5, 0x36dd4a, 0x5c0d4a, 0x460c95, 0x30952e, 0x540556, 0x3e0ab5, 0x2a55b2,
  0x5006d2, 0x38cea5, 0x5e0725, 0x48064b, 0x32ac97, 0x560cab, 0x42055a, 0x2c6ad6,
  0x520b69, 0x3d7752, 0x620b52, 0x4c0b25, 0x36da4b, 0x5a0a4b, 0x4404ab, 0x2ea55b,
  0x5405ad, 0x3e0b6a, 0x2a5b52, 0x500d92, 0x3afd25, 0x5e0d25, 0x480a55, 0x32b4ad,
  0x5804b6, 0x4005b5, 0x2c6daa, 0x520ec9, 0x3f1e92, 0x620e92, 0x4c0d26, 0x36ca56,
  0x5a0a57, 0x440556, 0x2e86d5, 0x540755, 0x400749, 0x286e93, 0x4e0693, 0x38f52b,
  0x5e052b, 0x460a5b, 0x32b55a, 0x58056a, 0x420b65, 0x2c974a, 0x520b4a, 0x3d1a95,
  0x620a95, 0x4a052d, 0x34caad, 0x5a0ab5, 0x4605aa, 0x2e8ba5, 0x540da5, 0x400d4a,
  0x2a7c95, 0x4e0c96, 0x38f94e, 0x5e0556, 0x480ab5, 0x32b5b2, 0x5806d2, 0x420ea5,
  0x2e8e4a, 0x50068b, 0x3b0c97, 0x6004ab, 0x4a055b, 0x34cad6, 0x5a0b6a, 0x460752,
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
  0xaa6, 0x4b6, 0x96d, 0x2ec, 0x6d9, 0xeb2, 0xd54, 0xd2a, 0xa56, 0x4ae,
  0x96d, 0xd6a, 0xb54, 0xb29, 0xa93, 0x52b, 0xa57, 0x536, 0xab5, 0x6aa,
  0xe93
};
static const int32_t UAQ_EPOCH_JDN = 2458373;   // 1 Muharram 1440 = 2018-09-11

static int32_t jdn(int y, int m, int d) {         // Julian day number (Gregorian)
  int a = (14 - m) / 12;
  int32_t yy = y + 4800 - a;
  int mm = m + 12 * a - 3;
  return d + (153 * mm + 2) / 5 + 365 * yy + yy / 4 - yy / 100 + yy / 400 - 32045;
}

// Gregorian -> Chinese lunar date (2000-2100). Returns false outside the table.
static bool lunarFromSolar(int y, int m, int d, int& ly, int& lm, int& ld, bool& leap) {
  if (y < 2000 || y > 2100) return false;
  int32_t day = jdn(y, m, d);
  ly = y;
  int32_t cny = jdn(y, 1, 1) + (int32_t)(LUNAR_INFO[y - 2000] >> 17);
  if (day < cny) {
    if (y == 2000) return false;
    ly = y - 1;
    cny = jdn(ly, 1, 1) + (int32_t)(LUNAR_INFO[ly - 2000] >> 17);
  }
  int32_t off = day - cny;
  uint32_t info = LUNAR_INFO[ly - 2000];
  int leapAfter = (info >> 13) & 15, n = leapAfter ? 13 : 12, num = 0;
  for (int i = 0; i < n; i++) {
    int len = ((info >> i) & 1) ? 30 : 29;
    if (leapAfter && i == leapAfter) leap = true;
    else { num++; leap = false; }
    if (off < len) { lm = num; ld = off + 1; return true; }
    off -= len;
  }
  return false;
}

static int termDay(int y, int k) {                 // k: 0 = 小寒 ... 23 = 冬至
  return TERM_BASE[k] + ((TERM_OFS[y - 2000][k >> 2] >> ((k & 3) * 2)) & 3);
}

// Today's solar term (-1 if none), and the next one with days until it
static void termInfo(int y, int m, int d, int& today, int& next, int& days) {
  int32_t t = jdn(y, m, d);
  today = -1; next = -1; days = 0;
  for (int step = 0; step < 4; step++) {           // this month's two terms, then next month's
    int yy = y, k = (m - 1) * 2 + step;
    if (k >= 24) { k -= 24; yy++; }
    if (yy > 2100) return;
    int32_t tj = jdn(yy, k / 2 + 1, termDay(yy, k));
    if (tj == t) today = k;
    if (tj > t) { next = k; days = tj - t; return; }
  }
}

// Tabular Islamic calendar (civil epoch): fallback outside the Umm al-Qura table
static void hijriTabular(int32_t j, int& hy, int& hm, int& hd) {
  int32_t l = j - 1948440 + 10632;
  int32_t n = (l - 1) / 10631;
  l = l - 10631 * n + 354;
  int32_t k = ((10985 - l) / 5316) * ((50 * l) / 17719) + (l / 5670) * ((43 * l) / 15238);
  l = l - ((30 - k) / 15) * ((17719 * k) / 50) - (k / 16) * ((15238 * k) / 43) + 29;
  hm = (24 * l) / 709;
  hd = l - (709 * hm) / 24;
  hy = 30 * n + k - 30;
}

// Julian day -> Hijri: Umm al-Qura 1440-1500 AH, tabular outside it
static bool hijriFromJdn(int32_t j, int& hy, int& hm, int& hd) {
  int32_t off = j - UAQ_EPOCH_JDN;
  if (off >= 0) {
    for (int yi = 0; yi < 61; yi++) {
      for (int mi = 0; mi < 12; mi++) {
        int len = ((UAQ_MONTHS[yi] >> mi) & 1) ? 30 : 29;
        if (off < len) { hy = 1440 + yi; hm = mi + 1; hd = off + 1; return true; }
        off -= len;
      }
    }
  }
  hijriTabular(j, hy, hm, hd);
  return false;
}

static const char* const CN_STEM[10]   = {"甲", "乙", "丙", "丁", "戊", "己", "庚", "辛", "壬", "癸"};
static const char* const CN_BRANCH[12] = {"子", "丑", "寅", "卯", "辰", "巳", "午", "未", "申", "酉", "戌", "亥"};
static const char* const CN_ZODIAC[12] = {"鼠", "牛", "虎", "兔", "龙", "蛇", "马", "羊", "猴", "鸡", "狗", "猪"};
static const char* const CN_MONTH[12]  = {"正", "二", "三", "四", "五", "六", "七", "八", "九", "十", "冬", "腊"};
static const char* const CN_TERM[24] = {
  "小寒", "大寒", "立春", "雨水", "惊蛰", "春分", "清明", "谷雨", "立夏", "小满", "芒种", "夏至",
  "小暑", "大暑", "立秋", "处暑", "白露", "秋分", "寒露", "霜降", "立冬", "小雪", "大雪", "冬至"};
// Hijri months in each Latin-script language (Chinese and Japanese write the month as a number)
static const char* const HIJRI_MONTH[L_COUNT][12] = {
  {"Muharram", "Safar", "Rabi I", "Rabi II", "Jumada I", "Jumada II", "Rajab", "Sha'ban", "Ramadan",
   "Shawwal", "Dhu al-Qa'dah", "Dhu al-Hijjah"},
  {}, {},
  {"Muharam", "Safar", "Rabiulawal", "Rabiulakhir", "Jumadilawal", "Jumadilakhir",   // KBBI
   "Rajab", "Syakban", "Ramadan", "Syawal", "Zulkaidah", "Zulhijah"},
  {"Muharram", "Safar", "Rabi' I", "Rabi' II", "Dschumada I", "Dschumada II", "Radschab", "Scha'ban",
   "Ramadan", "Schawwal", "Dhu l-Qa'da", "Dhu l-Hiddscha"},
  {"Mouharram", "Safar", "Rabia I", "Rabia II", "Joumada I", "Joumada II", "Rajab", "Chaabane",
   "Ramadan", "Chawwal", "Dhou al-Qi'da", "Dhou al-Hijja"},
  {},
  {"Muharram", "Safar", "Rabi I", "Rabi II", "Yumada I", "Yumada II", "Rayab", "Shabán", "Ramadán",
   "Shawwal", "Dhu al-Qada", "Dhu al-Hiyya"}};

// Chinese festivals on the lunar calendar (greetings for the buddy's ticker)
static const LunarDay LUNAR_DAYS[] = {
  {1, 1, "春节", "Happy Chinese New Year!"},
  {1, 15, "元宵节", "Happy Lantern Festival!"},
  {5, 5, "端午节", "Happy Dragon Boat Festival!"},
  {7, 7, "七夕", "Happy Qixi Festival!"},
  {7, 15, "中元节", "Ghost Festival today"},
  {8, 15, "中秋节", "Happy Mid-Autumn Festival!"},
  {9, 9, "重阳节", "Happy Double Ninth Festival!"},
  {12, 8, "腊八节", "Laba Festival today"},
};

// Buddhist days (Mahayana, lunar calendar). Vesak (Waisak) is computed separately.
static const BuddhistDay BUDDHIST_DAYS[] = {
  {2, 19, S_B_GUANYIN}, {4, 8, S_B_BUDDHA}, {7, 15, S_B_ULAMBANA}, {12, 8, S_B_BODHI}};

// Waisak 2000-2100 (Indonesia): lunar day (14 + 2 bits) of the full moon, in WIB,
// in the 4th Chinese lunar month. Matches the official dates 2019-2026.
static const uint8_t WAISAK_FM[26] = {0x95, 0xae, 0x56, 0xba, 0x5a, 0xe5, 0x56, 0xa9, 0x6b, 0xa5, 0xbe, 0x95, 0xea, 0x46, 0xa9, 0x5a, 0xf9, 0x6a, 0xa5, 0xab, 0x55, 0x6a, 0x95, 0xba, 0x55, 0x02};

static int waisakDay(int y) {                            // lunar day of Waisak in month 4
  int i = y - 2000;
  return 14 + ((WAISAK_FM[i >> 2] >> ((i & 3) * 2)) & 3);
}

static const LunarDay* lunarFestival(const CalInfo& c) {
  if (!c.lunarOk || c.leap) return nullptr;
  for (const LunarDay& f : LUNAR_DAYS)
    if (f.m == c.lm && f.d == c.ld) return &f;
  return nullptr;
}

static void cnDay(int d, char* out, size_t n) {          // 初一 ... 二十一 ... 三十
  static const char* const DIG[11] = {"", "一", "二", "三", "四", "五", "六", "七", "八", "九", "十"};
  if (d <= 10) snprintf(out, n, "初%s", DIG[d]);
  else if (d < 20) snprintf(out, n, "十%s", DIG[d - 10]);
  else if (d < 30) snprintf(out, n, "二十%s", DIG[d - 20]);   // 廿 isn't in the font
  else snprintf(out, n, "三十");
}

// Second Chinese line: festival, New Year's Eve, solar term, or the next term
static void lunarDayText(const CalInfo& c, char* out, size_t n) {
  const LunarDay* f = lunarFestival(c);
  if (f) snprintf(out, n, "%s", f->label);
  else if (c.eve) snprintf(out, n, "除夕");
  else if (c.termToday >= 0) snprintf(out, n, "今日%s", CN_TERM[c.termToday]);
  else if (c.termNext >= 0) snprintf(out, n, "%d天后%s", c.termDays, CN_TERM[c.termNext]);
  else out[0] = 0;
}

// Easter Sunday (Western, Gregorian): anonymous Gregorian algorithm, checked 2000-2100
static void easterDate(int y, int& m, int& d) {
  int a = y % 19, b = y / 100, c = y % 100, q = b / 4, e = b % 4, f = (b + 8) / 25, g = (b - f + 1) / 3;
  int h = (19 * a + b - q - g + 15) % 30, i = c / 4, k = c % 4;
  int l = (32 + 2 * e + 2 * i - h - k) % 7, mm = (a + 11 * h + 22 * l) / 451;
  m = (h + l - 7 * mm + 114) / 31;
  d = (h + l - 7 * mm + 114) % 31 + 1;
}

// Christmas and Easter days, or nullptr
static const char* christianDay(int y, int m, int d) {
  if (m == 12 && d == 24) return "Christmas Eve";
  if (m == 12 && d == 25) return "Christmas Day";
  int em, ed;
  easterDate(y, em, ed);
  int32_t diff = jdn(y, m, d) - jdn(y, em, ed);
  if (diff == -2) return "Good Friday";
  if (diff == 0)  return "Easter Sunday";
  return nullptr;
}

// Buddhist day in the chosen language, or nullptr
static const char* buddhistDay(const CalInfo& c, bool withUposatha) {
  if (!c.lunarOk) return nullptr;
  if (c.waisak) return T(S_G_VESAK);
  if (c.leap) return nullptr;
  for (const BuddhistDay& b : BUDDHIST_DAYS)
    if (b.m == c.lm && b.d == c.ld) return T(b.name);
  if (withUposatha && (c.ld == 1 || c.ld == 15)) return T(S_B_UPOSATHA);   // 初一 / 十五 observance days
  return nullptr;
}

// Islamic day in the chosen language, or nullptr
static const char* hijriEvent(const CalInfo& c) {
  if (c.hm == 1 && c.hd == 1)   return T(S_G_HIJRI_NY);
  if (c.hm == 3 && c.hd == 12)  return T(S_G_MAWLID);
  if (c.hm == 7 && c.hd == 27)  return T(S_G_ISRA);
  if (c.hm == 9 && c.hd == 1)   return T(S_G_RAMADAN);
  if (c.hm == 10 && c.hd == 1)  return T(S_G_EID_FITR);
  if (c.hm == 12 && c.hd == 9)  return T(S_G_ARAFAH);
  if (c.hm == 12 && c.hd == 10) return T(S_G_EID_ADHA);
  return nullptr;
}

static char gHinduGreet[64];                // "Happy Diwali!" in the chosen language (loop() only)

// Festival greeting for the buddy's ticker, if today is special (only for the calendars chosen)
// A Jewish festival in the chosen language, e.g. "Hanukkah, day 3"
static void hebFestText(const CalInfo& c, char* buf, size_t n) {
  static const Str NAME[] = {S_COUNT, S_JF_ROSH, S_JF_YOM_KIPPUR, S_JF_SUKKOT, S_JF_SHEMINI, S_JF_SIMCHAT,
                             S_JF_SHEMINI_SIMCHAT, S_JF_HANUKKAH, S_JF_TU_BISHVAT, S_JF_PURIM, S_JF_PESACH,
                             S_JF_SHAVUOT, S_JF_TISHA_BAV};
  buf[0] = 0;
  if (c.hebFest == astro::HF_NONE || c.hebFest >= sizeof(NAME) / sizeof(NAME[0])) return;
  snprintf(buf, n, T(NAME[c.hebFest]), c.hebFestN);
}

static const char* calGreeting(const CalInfo& c) {
  if (!c.valid) return nullptr;
  const LunarDay* f = (CALS & CAL_CHINESE) ? lunarFestival(c) : nullptr;
  if (f) {                                  // Chinese festivals: in the chosen language
    int k = f->m * 100 + f->d;
    return T(k == 101 ? S_G_CNY : k == 115 ? S_G_LANTERN : k == 505 ? S_G_DRAGON : k == 707 ? S_G_QIXI
           : k == 715 ? S_G_GHOST : k == 815 ? S_G_MIDAUTUMN : k == 909 ? S_G_DOUBLE9 : S_G_LABA);
  }
  if ((CALS & CAL_CHINESE) && c.eve) return T(S_G_CNY_EVE);
  if (CALS & CAL_BUDDHIST) {
    const char* b = buddhistDay(c, false);
    if (b) return b;
  }
  if (CALS & CAL_ISLAMIC) {
    const char* e = hijriEvent(c);
    if (e) return e;
  }
  if ((CALS & CAL_HINDU) && c.hinduFest) {
    char name[40];                          // "Diwali / Deepavali" -> the first name only
    strlcpy(name, c.hinduFest, sizeof(name));
    if (char* sl = strstr(name, " / ")) *sl = 0;
    snprintf(gHinduGreet, sizeof(gHinduGreet), T(S_HAPPY_FMT), name);
    return gHinduGreet;
  }
  if (CALS & CAL_JEWISH) {
    if (c.hebFest == astro::HF_ROSH) return T(S_G_SHANA_TOVA);
    if (c.hebFest == astro::HF_YOM_KIPPUR) return T(S_G_YOM_KIPPUR);
    if (c.hebFest == astro::HF_HANUKKAH) return T(S_G_HANUKKAH);
    if (c.hebFest != astro::HF_NONE) {      // Tisha B'Av is a fast day: no "happy"
      char f[64];
      hebFestText(c, f, sizeof(f));
      snprintf(gHebGreet, sizeof(gHebGreet), T(c.hebFest == astro::HF_TISHA_BAV ? S_G_FAST : S_G_CHAG), f);
      return gHebGreet;
    }
    if (c.shabbat) return T(S_G_SHABBAT);
  }
  if (c.christian) {
    if (c.christian[0] == 'C') return c.christian[10] == 'E' ? T(S_G_XMAS_EVE) : T(S_G_XMAS);
    if (c.christian[0] == 'E') return T(S_G_EASTER);
    return T(S_G_GOOD_FRIDAY);
  }
  if (c.holToday[0]) {                      // a public holiday where you are
    snprintf(gHolGreet, sizeof(gHolGreet), T(S_HOL_GREET), c.holToday);
    return gHolGreet;
  }
  return nullptr;
}

// Where Momowo is, for prayer times and sunrise: the live location, else the last one saved
static bool placeKnown(double& lat, double& lon) {
  LocationData l = getLocation();
  if (l.valid) { lat = l.lat; lon = l.lon; return true; }
  if (!isnan(gSavedLat) && !isnan(gSavedLon)) { lat = gSavedLat; lon = gSavedLon; return true; }
  lat = FIXED_LAT; lon = FIXED_LON;
  return false;
}

static double tzHours() { return gTzKnown ? gTzOffset / 3600.0 : 8.0; }   // FALLBACK_TZ is UTC+8

static int prayerMethod() {
  if (PRAY_METHOD < astro::METHOD_COUNT) return PRAY_METHOD;
  return astro::methodForCountry(homeCountry());
}

// Today's prayer times: once a day, or when the place or time zone changes
static void updatePrayers() {
  struct tm t;
  if (!(CALS & CAL_ISLAMIC) || !nowTm(t)) return;
  double lat, lon;
  bool known = placeKnown(lat, lon);
  // the method (country found after boot) and Ramadan (Hijri adjustment) change the times too
  int key = ((t.tm_yday * 7919 + (int)lround(lat * 10) * 31 + (int)lround(lon * 10)) ^ (int)(tzHours() * 4)) ^
            (prayerMethod() << 24) ^ ((gCal.hm == 9) << 29);
  if (gPray.valid && key == gPray.key) return;
  PrayerDay p;
  int y = t.tm_year + 1900, m = t.tm_mon + 1, d = t.tm_mday;
  double out[astro::PRAYER_COUNT];
  astro::prayerTimes(y, m, d, lat, lon, tzHours(), prayerMethod(), ASR_HANAFI, gCal.hm == 9, out);
  for (int i = 0; i < astro::PRAYER_COUNT; i++) p.t[i] = out[i];
  struct tm tt = t;                         // tomorrow's Fajr, for the countdown after Isha
  tt.tm_mday += 1;
  tt.tm_hour = 12;
  mktime(&tt);
  astro::prayerTimes(tt.tm_year + 1900, tt.tm_mon + 1, tt.tm_mday, lat, lon, tzHours(), prayerMethod(),
                     ASR_HANAFI, gCal.hm == 9, out);
  p.tmFajr = out[astro::FAJR];
  p.valid = true;
  (void)known;                              // before the first location: Singapore, until it's known
  p.key = key;
  gPray = p;
}

// Recompute when the day, the sunset flip or the Hijri adjustment changes
// Today's local sunset (minutes after midnight): from the forecast, else calculated
static int sunsetMinutes(const WeatherData& w, int y, int m, int d) {
  if (w.valid && w.sunsetMin >= 0) return w.sunsetMin;
  double lat, lon, out[astro::PRAYER_COUNT];
  placeKnown(lat, lon);
  astro::prayerTimes(y, m, d, lat, lon, tzHours(), 0, false, false, out);   // Maghrib = sunset here
  return isnan(out[astro::MAGHRIB]) ? -1 : (int)lround(out[astro::MAGHRIB]);
}

static void updateCalendar() {
  static int lastKey = -1;
  struct tm t;
  if (!nowTm(t)) { gCal.valid = false; return; }
  WeatherData w = getWeather();
  bool afterSunset = HIJRI_AT_SUNSET && w.valid && w.sunsetMin >= 0 &&
                     t.tm_hour * 60 + t.tm_min >= w.sunsetMin;
  int ssMin = sunsetMinutes(w, t.tm_year + 1900, t.tm_mon + 1, t.tm_mday);
  bool pastSunset = ssMin >= 0 && t.tm_hour * 60 + t.tm_min >= ssMin;   // the Hebrew day begins
  int key = ((((t.tm_year * 400 + t.tm_yday) * 2 + (afterSunset ? 1 : 0)) * 4 + (gHijriAdj + 1)) * 64 +
             (int)(gTzOffset / 1800) + (gLoc.valid ? 32 : 0)) * 2 + (pastSunset ? 1 : 0);
  { const char* hc = homeCountry(); key = key * 2 + (hc[0] == 'I' && hc[1] == 'L'); }   // Israel's festival days
  static uint16_t lastHol = 0xFFFF;
  if (key == lastKey && gCal.valid && lastHol == gHolVersion) return;
  lastKey = key;
  lastHol = gHolVersion;

  CalInfo c;
  int y = t.tm_year + 1900, m = t.tm_mon + 1, d = t.tm_mday;
  c.valid = true;
  c.wday = t.tm_wday;
  c.lunarOk = lunarFromSolar(y, m, d, c.ly, c.lm, c.ld, c.leap);
  // Indonesian Buddhist year: Gregorian + 543, +1 from Waisak (full moon of the 4th lunar month)
  bool afterWaisak = m > 6;                               // rough, outside 2000-2100
  if (c.lunarOk) {
    afterWaisak = false;
    if (c.ly == y) {
      int wd = waisakDay(y);
      afterWaisak = c.lm > 4 || (c.lm == 4 && (c.leap || c.ld >= wd));
      c.waisak = c.lm == 4 && !c.leap && c.ld == wd;
    }
  }
  c.be = y + 543 + (afterWaisak ? 1 : 0);
  c.christian = christianDay(y, m, d);
  if (c.lunarOk) {
    struct tm tt = t;                                     // tomorrow = 正月初一 -> today is 除夕
    tt.tm_mday += 1;
    tt.tm_hour = 12;
    mktime(&tt);
    int a, b, dd;
    bool L;
    c.eve = lunarFromSolar(tt.tm_year + 1900, tt.tm_mon + 1, tt.tm_mday, a, b, dd, L) && b == 1 && dd == 1 && !L;
  }
  if (y >= 2000 && y <= 2100) termInfo(y, m, d, c.termToday, c.termNext, c.termDays);
  hijriFromJdn(jdn(y, m, d) + gHijriAdj + (afterSunset ? 1 : 0), c.hy, c.hm, c.hd);
  if (CALS & CAL_HINDU) {                   // Hindu: the tithi at local sunrise
    double lat, lon, out[astro::PRAYER_COUNT];
    placeKnown(lat, lon);
    astro::prayerTimes(y, m, d, lat, lon, tzHours(), 0, false, false, out);
    double day0 = astro::julianDay(y, m, d) - tzHours() / 24.0;   // local midnight, as UT
    double rise = isnan(out[astro::SUNRISE]) ? 6 * 60 : out[astro::SUNRISE];
    double set = isnan(out[astro::MAGHRIB]) ? 18 * 60 : out[astro::MAGHRIB];
    double jdRise = day0 + rise / 1440.0, jdSet = day0 + set / 1440.0;
    c.pj = astro::panchang(jdRise, y, m);
    c.hinduFest = astro::hinduFestival(c.pj, jdRise, jdSet);
    c.hinduOk = true;
  }
  {                                         // Hebrew: the new day begins at sunset
    int32_t hy;
    int hm, hd;
    astro::hebFromRd(jdn(y, m, d) - 1721425 + (pastSunset ? 1 : 0), hy, hm, hd);
    c.hebOk = true;
    c.hebY = hy;
    c.hebM = hm;
    c.hebD = hd;
    int dow = (t.tm_wday + (pastSunset ? 1 : 0)) % 7;
    const char* cc = homeCountry();
    c.hebFest = astro::hebFestival(hy, hm, hd, dow, cc[0] == 'I' && cc[1] == 'L', &c.hebFestN);
    if (t.tm_wday == 5 && ssMin >= 18) c.candles = ssMin - 18;   // Friday: 18 min before sunset
    c.shabbat = dow == 6;                   // Friday evening until Saturday's sunset
  }
  xSemaphoreTake(gMutex, portMAX_DELAY);    // read by the network task too
  if (gHolYear == y || gHolYear == y - 1) { // public holidays: today, the next one, and this month's
    int today = jdn(y, m, d);
    for (int i = 0; i < gHolCount; i++)
      for (int hy = gHolYear; hy <= gHolYear + 1; hy++) {
        // early January comes round again on the same dates: seen from late December, and
        // on New Year's Day until the new year's list arrives
        if (hy > gHolYear && !(gHol[i].m == 1 && gHol[i].d <= 7)) break;
        int diff = jdn(hy, gHol[i].m, gHol[i].d) - today;
        if (hy == y && gHol[i].m == m) c.holMask |= 1UL << gHol[i].d;
        if (diff == 0 && !c.holToday[0]) strlcpy(c.holToday, gHol[i].name, sizeof(c.holToday));
        else if (diff > 0 && (c.holDays < 0 || diff < c.holDays)) {
          c.holDays = diff;
          strlcpy(c.holNext, gHol[i].name, sizeof(c.holNext));
        }
      }
  }
  gCal = c;
  xSemaphoreGive(gMutex);
}

// ============================ CLOCK CHIP (optional) ==================
// A DS3231 module on the display's I2C pins keeps the time through power cuts, so
// Momowo needs neither WiFi nor a phone once the time has been set. Stored as UTC.
#define RTC_ADDR 0x68
static uint8_t bcd2bin(uint8_t v) { return (v >> 4) * 10 + (v & 0x0F); }
static uint8_t bin2bcd(uint8_t v) { return ((v / 10) << 4) | (v % 10); }

static bool rtcLoad() {                     // clock chip -> system time; false if absent or unset
  if (motion::isMpu(RTC_ADDR)) return false;   // that's the MPU6050 (AD0 low), not a clock chip
  Wire.beginTransmission(RTC_ADDR);
  Wire.write(0x00);
  if (Wire.endTransmission() != 0) return false;
  gRtc = true;
  if (Wire.requestFrom(RTC_ADDR, 7) != 7) return false;
  uint8_t r[7];
  for (int i = 0; i < 7; i++) r[i] = Wire.read();
  int y = 2000 + bcd2bin(r[6]), mo = bcd2bin(r[5] & 0x1F), d = bcd2bin(r[4]);
  int h = bcd2bin(r[2] & 0x3F), mi = bcd2bin(r[1] & 0x7F), sec = bcd2bin(r[0] & 0x7F);
  if (y < 2024 || mo < 1 || mo > 12 || d < 1 || d > 31 || h > 23 || mi > 59 || sec > 59) return false;
  struct timeval tv = { (time_t)(jdn(y, mo, d) - jdn(1970, 1, 1)) * 86400 + h * 3600 + mi * 60 + sec, 0 };
  settimeofday(&tv, nullptr);
  Serial.println("[clock] time loaded from the clock chip");
  return true;
}

static void rtcSave() {                     // system time -> clock chip
  time_t now = time(nullptr);
  if (!gRtc || now < 1700000000) return;
  struct tm u;
  gmtime_r(&now, &u);
  Wire.beginTransmission(RTC_ADDR);
  Wire.write(0x00);
  Wire.write(bin2bcd(u.tm_sec));
  Wire.write(bin2bcd(u.tm_min));
  Wire.write(bin2bcd(u.tm_hour));           // 24-hour mode
  Wire.write(u.tm_wday + 1);
  Wire.write(bin2bcd(u.tm_mday));
  Wire.write(bin2bcd(u.tm_mon + 1));
  Wire.write(bin2bcd(u.tm_year - 100));
  Wire.endTransmission();
}

// ============================ NETWORK (core 0) =======================
// A web reply's Date ("Mon, 19 Oct 2026 01:14:26 GMT") sets the clock while NTP hasn't answered
// (some office and guest networks block it). NTP still takes over if it ever does.
static void timeFromHttpDate(const char* d) {
  static const char MON[] = "JanFebMarAprMayJunJulAugSepOctNovDec";
  char m[4];
  int dd, yy, hh, mi, ss;
  if (sscanf(d, "%*[^,], %d %3s %d %d:%d:%d", &dd, m, &yy, &hh, &mi, &ss) != 6 || yy < 2024 || yy > 2100) return;
  const char* p = strstr(MON, m);
  if (!p || (p - MON) % 3) return;
  struct timeval tv = {(time_t)(jdn(yy, (p - MON) / 3 + 1, dd) - jdn(1970, 1, 1)) * 86400 + hh * 3600 + mi * 60 + ss, 0};
  settimeofday(&tv, nullptr);
  Serial.println("[clock] set from a web reply (no NTP yet)");
}

static bool httpGet(const char* url, String& out) {
  bool tls = strncmp(url, "https", 5) == 0;
  WiFiClientSecure secure;
  WiFiClient plain;
  if (tls) {
    secure.setInsecure();                   // hobby device: skip cert checks
    secure.setHandshakeTimeout(10);         // seconds (the default 120 s would stall everything)
  }
  HTTPClient http;
  http.setConnectTimeout(8000);
  http.setTimeout(8000);
  if (!http.begin(tls ? (WiFiClient&)secure : plain, url)) return false;
  http.addHeader("User-Agent", "Momowo-ESP32");
  static const char* DATE_HDR[] = {"Date"};
  http.collectHeaders(DATE_HDR, 1);
  int code = http.GET();
  if (code > 0 && time(nullptr) < 1700000000) timeFromHttpDate(http.header("Date").c_str());
  bool ok = (code == HTTP_CODE_OK);
  if (ok) out = http.getString();
  http.end();
  return ok;
}

static bool sLocMoved = false;              // netTask only

static void storeLocation(float lat, float lon, const char* city) {
  xSemaphoreTake(gMutex, portMAX_DELAY);
  if (!gLoc.valid || fabsf(gLoc.lat - lat) > 0.05f || fabsf(gLoc.lon - lon) > 0.05f) sLocMoved = true;
  gLoc.valid = true;
  gLoc.lat = lat;
  gLoc.lon = lon;
  char c[40];
  asciiize(city, c, sizeof(c));
  if (strcmp(c, gLoc.city)) {               // a new place: show its English name until translated
    strlcpy(gLoc.city, c, sizeof(gLoc.city));
    strlcpy(gLoc.name, c, sizeof(gLoc.name));
  }
  xSemaphoreGive(gMutex);
  if (isnan(gSavedLat) || fabsf(gSavedLat - lat) > 0.05f) { gSavedLat = lat; prefs.putFloat("lat", lat); }
  if (isnan(gSavedLon) || fabsf(gSavedLon - lon) > 0.05f) { gSavedLon = lon; prefs.putFloat("lon", lon); }
}

// Does the font have every character of s? Own font state: netTask only.
static bool fontHasAll(const char* s, const uint8_t* font) {
  static u8g2_font_t chk = {};
  u8g2_SetFont(&chk, font);
  const uint8_t* p = (const uint8_t*)s;
  for (uint32_t cp; (cp = utf8Next(p));) {
    if (cp < 0x80) continue;
    if ((cp & 0x80000000u) || cp > 0xFFFF || !u8g2_IsGlyph(&chk, (uint16_t)cp)) return false;
  }
  return true;
}

// The place's name in the chosen language (Open-Meteo / GeoNames), for the screen. Picks the match
// nearest to our coordinates; keeps English if there's none, or if the font can't draw it all.
static void localizeCity() {
  static const char* const GEO_LANG[L_COUNT] = {"en", "zh", "zh", "id", "de", "fr", "ja", "es"};
  static char doneFor[40] = "";             // finished for this place (the language only changes on restart)
  static uint32_t retryAt = 0;              // after a temporary failure, wait before trying again
  char city[40];
  float lat, lon;
  xSemaphoreTake(gMutex, portMAX_DELAY);
  strlcpy(city, gLoc.city, sizeof(city));
  lat = gLoc.lat;
  lon = gLoc.lon;
  bool valid = gLoc.valid;
  xSemaphoreGive(gMutex);
  if (!valid || !city[0] || !strcmp(doneFor, city)) return;
  if (retryAt && (int32_t)(millis() - retryAt) < 0) return;
  if (LANG == L_EN) { strlcpy(doneFor, city, sizeof(doneFor)); return; }

  auto setName = [&](const char* name) {
    xSemaphoreTake(gMutex, portMAX_DELAY);
    if (!strcmp(gLoc.city, city)) utf8Copy(gLoc.name, name, sizeof(gLoc.name));
    xSemaphoreGive(gMutex);
  };
  // usable = something to show; for Chinese/Japanese it must really be in that script, all drawable
  auto usable = [&](const char* n) {
    if (!n[0] || isRefusal(n) || strchr(n, '\n')) return false;
    return !langIsCjk() || (hasCjk(n) && fontHasAll(n, cjkFont()));
  };

  // 1. Saved from an earlier start-up: no network needed
  char key[48], saved[64] = "", savedFor[48] = "";
  snprintf(key, sizeof(key), "%s|%d", city, LANG);
  prefs.getString("locfor", savedFor, sizeof(savedFor));
  prefs.getString("locname", saved, sizeof(saved));
  if (!strcmp(savedFor, key) && usable(saved)) {
    setName(saved);
    strlcpy(doneFor, city, sizeof(doneFor));
    return;
  }

  // 2. Open-Meteo (GeoNames): the match nearest our coordinates
  char q[96], url[240], best[64] = "";
  size_t o = 0;
  for (const uint8_t* c = (const uint8_t*)city; *c && o + 4 < sizeof(q); c++) {
    if (isalnum(*c) || *c == '-' || *c == '.' || *c == '_') q[o++] = (char)*c;
    else o += snprintf(q + o, sizeof(q) - o, "%%%02X", *c);         // URL-encode
  }
  q[o] = 0;
  snprintf(url, sizeof(url), "https://geocoding-api.open-meteo.com/v1/search?name=%s&count=10&language=%s",
           q, GEO_LANG[LANG]);
  String body;
  JsonDocument doc;
  bool netOk = httpGet(url, body) && !deserializeJson(doc, body);
  if (netOk) {
    float bestD = 1.0f;                     // within about 100 km, so a namesake elsewhere won't match
    for (JsonObject r : doc["results"].as<JsonArray>()) {
      float d = fabsf((r["latitude"] | 999.0f) - lat) + fabsf((r["longitude"] | 999.0f) - lon);
      const char* n = r["name"] | "";
      if (d < bestD && n[0]) { bestD = d; utf8Copy(best, n, sizeof(best)); }
    }
  }
  bool good = usable(best);
  if (!good && best[0]) Serial.printf("[geo] \"%s\" isn't a %s name\n", best, LANG_NAME[LANG]);

  // 3. Chinese/Japanese and still nothing (common for suburbs): ask Claude once, if AI is on
  if (!good && langIsCjk() && AI_API_KEY[0]) {
    char prompt[300], ai[96];
    snprintf(prompt, sizeof(prompt),
             "What do %s speakers call the place \"%s\" (latitude %.2f, longitude %.2f)? If it has no "
             "established name, write it the way they naturally would (katakana for Japanese, a "
             "transliteration for Chinese). Reply with the name only.", LANG_NAME[LANG], city, lat, lon);
    if (!askAI(prompt, ai, sizeof(ai), 40, false)) {   // asleep, offline or busy: try later
      retryAt = millis() + 30UL * 60 * 1000;
      if (!retryAt) retryAt = 1;
      return;
    }
    if (usable(ai)) { utf8Copy(best, ai, sizeof(best)); good = true; }
  }
  if (!netOk && !good) {                    // couldn't reach Open-Meteo: try again later
    retryAt = millis() + 10UL * 60 * 1000;
    if (!retryAt) retryAt = 1;
    return;
  }
  retryAt = 0;
  strlcpy(doneFor, city, sizeof(doneFor));
  if (!good) { Serial.printf("[geo] no %s name for %s, keeping English\n", LANG_NAME[LANG], city); return; }
  setName(best);
  prefs.putString("locfor", key);           // remembered, so restarts need no lookup
  prefs.putString("locname", best);
  Serial.printf("[geo] %s is \"%s\" in %s\n", city, best, LANG_NAME[LANG]);
}

// Suburb name or postcode -> coordinates (Open-Meteo geocoding, no key)
static bool geocodeSuburb() {
  char q[3 * sizeof(SUBURB) + 1], url[320];
  size_t o = 0;
  for (const uint8_t* p = (const uint8_t*)SUBURB; *p && o + 4 < sizeof(q); p++) {
    if (isalnum(*p) || *p == '-' || *p == '.' || *p == '_') q[o++] = (char)*p;
    else o += snprintf(q + o, sizeof(q) - o, "%%%02X", *p);         // URL-encode
  }
  q[o] = 0;
  snprintf(url, sizeof(url), "https://geocoding-api.open-meteo.com/v1/search?name=%s&count=1%s%s",
           q, COUNTRY_CODE[0] ? "&countryCode=" : "", COUNTRY_CODE);
  String body;
  JsonDocument doc;
  if (!httpGet(url, body) || deserializeJson(doc, body)) {
    Serial.println("[geo] suburb lookup failed");
    return false;
  }
  JsonObject r = doc["results"][0];
  if (r.isNull()) {
    Serial.printf("[geo] no place found for \"%s\"\n", SUBURB);
    return false;
  }
  float lat = r["latitude"] | 0.0f, lon = r["longitude"] | 0.0f;
  storeLocation(lat, lon, r["name"] | (const char*)SUBURB);
  Serial.printf("[geo] %s -> %s, %s (%.4f, %.4f)\n", SUBURB, r["name"] | "", r["admin1"] | "", lat, lon);
  return true;
}

static char gCountry[48] = "";              // country name from the IP lookup (netTask only), for AI

// Where am I? ip-api.com first (free tier is plain HTTP), ipwho.is as backup
static bool geolocate() {
  String body;
  JsonDocument doc;
  if (httpGet("http://ip-api.com/json/?fields=status,country,countryCode,city,lat,lon,offset", body) &&
      !deserializeJson(doc, body) && strcmp(doc["status"] | "", "success") == 0) {
    storeLocation(doc["lat"] | 0.0f, doc["lon"] | 0.0f, doc["city"] | "");
    asciiize(doc["country"] | "", gCountry, sizeof(gCountry));
    strlcpy(gCountryCode, doc["countryCode"] | "", sizeof(gCountryCode));
    if (prefs.getString("ipcc", "") != gCountryCode) prefs.putString("ipcc", gCountryCode);   // known at boot
    if (!doc["offset"].isNull()) netTzOffset(doc["offset"].as<int32_t>());
    return true;
  }
  body = "";
  if (httpGet("https://ipwho.is/?fields=success,country,country_code,city,latitude,longitude,timezone", body) &&
      !deserializeJson(doc, body) && (doc["success"] | false)) {
    storeLocation(doc["latitude"] | 0.0f, doc["longitude"] | 0.0f, doc["city"] | "");
    asciiize(doc["country"] | "", gCountry, sizeof(gCountry));
    strlcpy(gCountryCode, doc["country_code"] | "", sizeof(gCountryCode));
    if (prefs.getString("ipcc", "") != gCountryCode) prefs.putString("ipcc", gCountryCode);
    if (!doc["timezone"]["offset"].isNull()) netTzOffset(doc["timezone"]["offset"].as<int32_t>());
    return true;
  }
  return false;
}

static bool fetchWeather() {
  LocationData loc = getLocation();
  if (!loc.valid) return false;
  char url[440];
  snprintf(url, sizeof(url),
    "https://api.open-meteo.com/v1/forecast?latitude=%.4f&longitude=%.4f"
    "&current=temperature_2m,relative_humidity_2m,apparent_temperature,is_day,weather_code,wind_speed_10m"
    "&daily=weather_code,temperature_2m_max,temperature_2m_min,precipitation_probability_max,"
    "wind_speed_10m_max,sunrise,sunset&timezone=auto&forecast_days=5", loc.lat, loc.lon);

  String body;
  if (!httpGet(url, body)) return false;
  JsonDocument doc;
  if (deserializeJson(doc, body)) return false;
  JsonObject cur = doc["current"];
  if (cur.isNull()) return false;

  // Open-Meteo reports the local UTC offset (DST-aware): keeps the clock right
  if (!doc["utc_offset_seconds"].isNull()) netTzOffset(doc["utc_offset_seconds"].as<int32_t>());

  WeatherData w;
  w.valid      = true;
  w.temp       = cur["temperature_2m"] | 0.0f;
  w.feels      = cur["apparent_temperature"] | w.temp;
  w.humidity   = cur["relative_humidity_2m"] | 0;
  w.code       = cur["weather_code"] | 0;
  w.wind       = cur["wind_speed_10m"] | 0.0f;
  w.isDay      = (cur["is_day"] | 1) == 1;
  w.tmax       = doc["daily"]["temperature_2m_max"][0] | w.temp;
  w.tmin       = doc["daily"]["temperature_2m_min"][0] | w.temp;
  w.rainChance = doc["daily"]["precipitation_probability_max"][0] | 0;
  auto hhmm = [](const char* iso) {                     // "YYYY-MM-DDTHH:MM" -> minutes
    return strlen(iso) >= 16 ? atoi(iso + 11) * 60 + atoi(iso + 14) : -1;
  };
  w.sunriseMin = hhmm(doc["daily"]["sunrise"][0] | "");
  w.sunsetMin  = hhmm(doc["daily"]["sunset"][0] | "");
  w.tmSunrise  = hhmm(doc["daily"]["sunrise"][1] | "");
  w.tmSunset   = hhmm(doc["daily"]["sunset"][1] | "");
  JsonObject daily = doc["daily"];                        // index 1 = tomorrow
  w.tmValid = !daily["temperature_2m_max"][1].isNull();
  w.tmMax   = daily["temperature_2m_max"][1] | 0.0f;
  w.tmMin   = daily["temperature_2m_min"][1] | 0.0f;
  w.tmCode  = daily["weather_code"][1] | 0;
  w.tmRain  = daily["precipitation_probability_max"][1] | 0;
  w.tmWind  = daily["wind_speed_10m_max"][1] | 0.0f;
  for (int i = 0; i < 5; i++) {                           // today and the next four days
    if (daily["temperature_2m_max"][i].isNull()) break;
    w.dMax[i]  = (int8_t)lroundf(daily["temperature_2m_max"][i] | 0.0f);
    w.dMin[i]  = (int8_t)lroundf(daily["temperature_2m_min"][i] | 0.0f);
    w.dCode[i] = daily["weather_code"][i] | 0;
    w.dRain[i] = daily["precipitation_probability_max"][i] | 0;
    w.days = i + 1;
  }
  // Air quality (Open-Meteo, from the Copernicus CAMS model); the weather is shown without it too
  snprintf(url, sizeof(url), "https://air-quality-api.open-meteo.com/v1/air-quality?latitude=%.4f"
           "&longitude=%.4f&current=us_aqi,pm2_5,pm10", loc.lat, loc.lon);
  JsonDocument air;
  if (httpGet(url, body) && !deserializeJson(air, body) && !air["current"]["us_aqi"].isNull()) {
    w.aqi  = air["current"]["us_aqi"].as<int>();
    w.pm25 = air["current"]["pm2_5"] | -1.0f;
    w.pm10 = air["current"]["pm10"] | -1.0f;
  }

  w.at = millis();
  xSemaphoreTake(gMutex, portMAX_DELAY);
  gWeather = w;
  xSemaphoreGive(gMutex);
  return true;
}

static void formatSource(char* out, size_t n, const char* who, const char* from) {
  bool hasWho = who && *who, hasFrom = from && *from;
  // "──" is U+2500: the GB2312 font has no glyph for the em dash U+2014
  if (hasWho && hasFrom && strcmp(who, from) != 0) snprintf(out, n, "── %s《%s》", who, from);
  else if (hasFrom) snprintf(out, n, "──《%s》", from);
  else if (hasWho)  snprintf(out, n, "── %s", who);
  else out[0] = 0;
}

// Philosophy-category quotes are only kept if they come from a classical thinker or work
static bool isClassicalSource(const char* who, const char* from) {
  static const char* const CLASSICAL[] = {
    "老子", "孔子", "庄子", "孟子", "荀子", "墨子", "韩非", "孙子", "列子", "管子",
    "论语", "道德经", "礼记", "诗经", "周易", "易经", "中庸", "尚书", "左传", "史记",
    "战国策", "淮南子", "鬼谷子", "菜根谭", "增广贤文"};
  for (const char* c : CLASSICAL)
    if (strstr(who, c) || strstr(from, c)) return true;
  return false;
}

// Swap punctuation the GB2312 font can't draw for close equivalents it can:
// em/en dash and horizontal bar -> "─" (U+2500); middle dots -> space.
static void normalizeCJK(const char* in, char* out, size_t outSz) {
  const uint8_t* p = (const uint8_t*)in;
  size_t o = 0;
  while (*p && o + 4 < outSz) {
    if (*p == '\n' || *p == '\r') { p++; continue; }
    if (p[0] == 0xE2 && p[1] == 0x80 && (p[2] == 0x93 || p[2] == 0x94 || p[2] == 0x95)) {
      out[o++] = (char)0xE2; out[o++] = (char)0x94; out[o++] = (char)0x80;
      p += 3;
    } else if ((p[0] == 0xC2 && p[1] == 0xB7) || (p[0] == 0xE2 && p[1] == 0x80 && p[2] == 0xA2) ||
               (p[0] == 0xE3 && p[1] == 0x83 && p[2] == 0xBB)) {
      out[o++] = ' ';
      p += (p[0] == 0xC2) ? 2 : 3;
    } else {
      out[o++] = (char)*p++;
    }
  }
  out[o] = 0;
}

// True if `font` has a glyph for every character of s. Uses its own font
// state, so it is safe to call from core 0 while core 1 draws.
static bool fontCovers(const char* s, const uint8_t* font) {
  static u8g2_font_t chk = {};
  u8g2_SetFont(&chk, font);
  const uint8_t* p = (const uint8_t*)s;
  while (*p) {
    uint32_t cp;
    int n;
    if (*p < 0x80) { cp = *p; n = 1; }
    else if ((*p & 0xE0) == 0xC0 && p[1]) { cp = ((*p & 0x1Fu) << 6) | (p[1] & 0x3Fu); n = 2; }
    else if ((*p & 0xF0) == 0xE0 && p[1] && p[2]) {
      cp = ((*p & 0x0Fu) << 12) | ((p[1] & 0x3Fu) << 6) | (p[2] & 0x3Fu);
      n = 3;
    } else return false;                    // outside the fonts' range, or malformed
    if (!u8g2_IsGlyph(&chk, (uint16_t)cp)) return false;
    p += n;
  }
  return true;
}

static bool quoteDrawable(const char* q, const char* src) {
  return fontCovers(q, CJK_FONT_BIG) && fontCovers(src, CJK_FONT);
}

// One short line from a 今日诗词 category (classical poetry), retrying for length
static bool fetchJinrishici(const char* path, const char* tag, int tries) {
  char url[80], src[96];
  snprintf(url, sizeof(url), "https://v1.jinrishici.com/%s.json", path);
  String body;
  JsonDocument doc;
  for (int i = 0; i < tries; i++) {
    if (i) vTaskDelay(pdMS_TO_TICKS(400));
    body = "";
    if (!httpGet(url, body) || deserializeJson(doc, body)) {
      Serial.printf("[quote] %s: request failed\n", path);
      return false;
    }
    char q[256], raw[96];
    normalizeCJK(doc["content"] | "", q, sizeof(q));
    if (!*q || utf8Count(q) > QUOTE_MAX_CHARS) continue;          // too long: try again
    formatSource(raw, sizeof(raw), doc["author"] | "", doc["origin"] | "");
    normalizeCJK(raw, src, sizeof(src));
    if (!quoteDrawable(q, src)) {
      Serial.printf("[quote] %s: skipped, font lacks a character: %s\n", path, q);
      continue;
    }
    Serial.printf("[quote] %s: %s %s\n", path, q, src);
    setQuote(q, src, tag);
    return true;
  }
  Serial.printf("[quote] %s: no short line in %d tries\n", path, tries);
  return false;
}

// Hitokoto: classical poetry, or philosophy only from classical thinkers
static bool fetchHitokotoClassical() {
  char url[96], src[96];
  snprintf(url, sizeof(url), "https://v1.hitokoto.cn/?c=i&c=k&encode=json&max_length=%d", QUOTE_MAX_CHARS);
  String body;
  JsonDocument doc;
  for (int tries = 0; tries < 5; tries++) {
    if (tries) vTaskDelay(pdMS_TO_TICKS(400));
    body = "";
    if (!httpGet(url, body) || deserializeJson(doc, body)) {
      Serial.println("[quote] hitokoto: request failed");
      return false;
    }
    const char* type = doc["type"] | "";
    const char* who  = doc["from_who"] | "";
    const char* from = doc["from"] | "";
    char q[256], raw[96];
    normalizeCJK(doc["hitokoto"] | "", q, sizeof(q));
    if (!*q || utf8Count(q) > QUOTE_MAX_CHARS) continue;
    if (strcmp(type, "k") == 0 && !isClassicalSource(who, from)) continue;   // modern philosophy
    formatSource(raw, sizeof(raw), who, from);
    normalizeCJK(raw, src, sizeof(src));
    if (!quoteDrawable(q, src)) {
      Serial.printf("[quote] hitokoto: skipped, font lacks a character: %s\n", q);
      continue;
    }
    Serial.printf("[quote] hitokoto: %s %s\n", q, src);
    setQuote(q, src, "");
    return true;
  }
  return false;
}

// Themed quote first; if that category has no short line, any classical quote
// Built-in classical Chinese quotes (all public domain), used when offline.
// Each: theme, text (max 12 characters), author, work, English meaning.
// Checked: every character is in the display font; source lines fall back to
// title-only or author-only where a name uses a rarer character.
static const LocalQuote LOCAL_QUOTES[] = {
  {T_MOON, "床前明月光，疑是地上霜。", "李白", "静夜思", "Moonlight before my bed: I took it for frost on the ground."},
  {T_MOON, "举头望明月，低头思故乡。", "李白", "静夜思", "I raise my head to the bright moon, then lower it, thinking of home."},
  {T_MOON, "海上生明月，天涯共此时。", "张九龄", "望月怀远", "The bright moon rises over the sea; far apart, we share this moment."},
  {T_MOON, "明月几时有？把酒问青天。", "", "水调歌头", "When did the bright moon first appear? Cup in hand, I ask the sky."},
  {T_MOON, "露从今夜白，月是故乡明。", "杜甫", "月夜忆舍弟", "From tonight the dew turns white; the moon shines brightest over home."},
  {T_MOON, "月落乌啼霜满天", "张继", "枫桥夜泊", "The moon sets, crows call, and frost fills the sky."},
  {T_STARS, "危楼高百尺，手可摘星辰。", "李白", "夜宿山寺", "The tower soars so high, I could pluck the stars by hand."},
  {T_STARS, "星垂平野阔，月涌大江流。", "杜甫", "旅夜书怀", "Stars hang low over the wide plain; the moon surges with the great river."},
  {T_STARS, "卧看牵牛织女星", "杜牧", "秋夕", "Lying back, I watch the Herd Boy and Weaver Girl stars."},
  {T_SUN, "白日依山尽，黄河入海流。", "王之涣", "", "The sun sinks behind the hills; the Yellow River flows into the sea."},
  {T_SUN, "欲穷千里目，更上一层楼。", "王之涣", "", "To see a thousand miles further, climb one more floor."},
  {T_SUN, "大漠孤烟直，长河落日圆。", "王维", "使至塞上", "Lone smoke rises straight over the desert; the sun sets round over the river."},
  {T_SUN, "夕阳无限好，只是近黄昏。", "李商隐", "登乐游原", "The setting sun is endlessly beautiful, though dusk draws near."},
  {T_SUN, "日出江花红胜火", "白居易", "忆江南", "At sunrise, the river flowers glow redder than fire."},
  {T_RAIN, "好雨知时节，当春乃发生。", "杜甫", "春夜喜雨", "Good rain knows its season, and comes just as spring arrives."},
  {T_RAIN, "随风潜入夜，润物细无声。", "杜甫", "春夜喜雨", "It slips into the night on the wind, quietly nourishing everything."},
  {T_RAIN, "夜来风雨声，花落知多少。", "孟浩然", "春晓", "Wind and rain in the night: how many blossoms fell?"},
  {T_RAIN, "山色空蒙雨亦奇", "", "饮湖上初晴后雨", "Misty hills are lovely in the rain too."},
  {T_RAIN, "清明时节雨纷纷", "杜牧", "清明", "At Qingming the rain falls soft and steady."},
  {T_SNOW, "千山鸟飞绝，万径人踪灭。", "柳宗元", "江雪", "No birds over a thousand hills, no footprints on ten thousand paths."},
  {T_SNOW, "千树万树梨花开", "", "白雪歌送武判官归京", "Ten thousand trees burst into pear blossom: the snow has come."},
  {T_SNOW, "柴门闻犬吠，风雪夜归人。", "刘长卿", "", "A dog barks at the gate: someone is coming home through the snowy night."},
  {T_CLOUD, "行到水穷处，坐看云起时。", "王维", "终南别业", "Walk to where the stream ends, then sit and watch the clouds rise."},
  {T_CLOUD, "众鸟高飞尽，孤云独去闲。", "李白", "独坐敬亭山", "The birds have flown away; a lone cloud drifts off at ease."},
  {T_CLOUD, "白云千载空悠悠", "", "黄鹤楼", "White clouds have drifted idly for a thousand years."},
  {T_WIND, "长风破浪会有时", "李白", "行路难", "A day will come to ride the wind and cut through the waves."},
  {T_WIND, "野火烧不尽，春风吹又生。", "白居易", "赋得古原草送别", "Wildfire cannot burn it all; the spring wind brings it back to life."},
  {T_WIND, "二月春风似剪刀", "贺知章", "咏柳", "The spring breeze of the second month is like scissors, shaping the willow."},
  {T_SPRING, "春眠不觉晓，处处闻啼鸟。", "孟浩然", "春晓", "Spring sleep, unaware of dawn; birdsong everywhere."},
  {T_SPRING, "万紫千红总是春", "", "春日", "Countless colours everywhere: it is spring."},
  {T_SPRING, "春色满园关不住", "叶绍翁", "游园不值", "A garden full of spring cannot be shut in."},
  {T_SPRING, "春风又绿江南岸", "王安石", "泊船瓜洲", "The spring wind turns the south bank green again."},
  {T_SUMMER, "小荷才露尖尖角", "杨万里", "小池", "A young lotus has just shown its pointed tip."},
  {T_SUMMER, "接天莲叶无穷碧", "杨万里", "晓出净慈寺送林子方", "Lotus leaves stretch to the sky in endless green."},
  {T_SUMMER, "绿树阴浓夏日长", "", "山亭夏日", "Green trees cast deep shade; summer days are long."},
  {T_AUTUMN, "停车坐爱枫林晚", "杜牧", "山行", "I stop the carriage, loving the maple woods at dusk."},
  {T_AUTUMN, "霜叶红于二月花", "杜牧", "山行", "Frosted leaves are redder than spring flowers."},
  {T_AUTUMN, "我言秋日胜春朝", "刘禹锡", "秋词", "I say an autumn day is finer than a spring morning."},
  {T_AUTUMN, "空山新雨后，天气晚来秋。", "王维", "", "After fresh rain in the empty hills, evening brings the feel of autumn."},
  {T_AUTUMN, "采菊东篱下，悠然见南山。", "陶渊明", "饮酒", "Picking chrysanthemums by the eastern fence, I calmly see the southern hills."},
  {T_WINTER, "墙角数枝梅，凌寒独自开。", "王安石", "梅花", "A few plum branches in the corner bloom alone against the cold."},
  {T_WINTER, "晚来天欲雪，能饮一杯无？", "白居易", "问刘十九", "Evening, and snow is coming. Will you share a cup with me?"},
  {T_WINTER, "梅须逊雪三分白", "卢梅坡", "雪梅", "The plum blossom must yield a little to the snow in whiteness."},
  {T_NONE, "千里之行，始于足下。", "老子", "道德经", "A journey of a thousand miles begins beneath your feet."},
  {T_NONE, "上善若水。", "老子", "道德经", "The highest good is like water."},
  {T_NONE, "知足者富。", "老子", "道德经", "Whoever knows contentment is rich."},
  {T_NONE, "学而时习之，不亦说乎？", "孔子", "论语", "To learn and practise what you learn: is that not a joy?"},
  {T_NONE, "有朋自远方来，不亦乐乎？", "孔子", "论语", "A friend comes from afar: is that not a delight?"},
  {T_NONE, "三人行，必有我师焉。", "孔子", "论语", "Walking with any two others, I will find a teacher among them."},
  {T_NONE, "己所不欲，勿施于人。", "孔子", "论语", "Do not do to others what you would not want for yourself."},
  {T_NONE, "天行健，君子以自强不息", "", "周易", "As heaven moves on without rest, keep growing stronger."},
  {T_NONE, "海内存知己，天涯若比邻。", "王勃", "送杜少府之任蜀州", "With a true friend in the world, the far ends of the earth feel next door."},
  {T_NONE, "天生我材必有用", "李白", "将进酒", "Heaven gave me my talents for a reason."},
  {T_NONE, "莫愁前路无知己", "高适", "别董大", "Don't worry: friends are waiting on the road ahead."},
  {T_NONE, "柳暗花明又一村", "陆游", "游山西村", "Past the shady willows and bright flowers, another village appears."},
  {T_NONE, "心远地自偏", "陶渊明", "饮酒", "When the heart is at peace, any place is quiet."},
  {T_NONE, "宁静致远", "诸葛亮", "诫子书", "Calm lets you reach far."},
};
static const int LOCAL_QUOTE_COUNT = sizeof(LOCAL_QUOTES) / sizeof(LOCAL_QUOTES[0]);

// A built-in quote for the theme (or a general one), with its English meaning
static bool pickLocalQuote(QTheme th) {
  static int last = -1;
  int idx[LOCAL_QUOTE_COUNT], n = 0;
  for (int i = 0; i < LOCAL_QUOTE_COUNT; i++)
    if (LOCAL_QUOTES[i].theme == th && i != last) idx[n++] = i;
  if (!n)
    for (int i = 0; i < LOCAL_QUOTE_COUNT; i++)
      if (LOCAL_QUOTES[i].theme == T_NONE && i != last) idx[n++] = i;
  if (!n) return false;
  last = idx[esp_random() % n];
  const LocalQuote& q = LOCAL_QUOTES[last];
  char src[96];
  formatSource(src, sizeof(src), q.who, q.from);
  setQuote(q.text, src, (q.theme != T_NONE) ? THEME_TAG[q.theme] : "");
  xSemaphoreTake(gMutex, portMAX_DELAY);
  strlcpy(gQuote.meaning, q.meaning, sizeof(gQuote.meaning));
  gQuote.version++;
  xSemaphoreGive(gMutex);
  return true;
}

// The verses of one scripture source
static const Verse* verseList(QKind kind, int& count) {
  switch (kind) {
    case Q_BIBLE: count = COUNT_OF(BIBLE_VERSES); return BIBLE_VERSES;
    case Q_QURAN: count = COUNT_OF(QURAN_VERSES); return QURAN_VERSES;
    case Q_TORAH: count = COUNT_OF(TORAH_VERSES); return TORAH_VERSES;
    case Q_DHAMMA: count = COUNT_OF(DHAMMAPADA_VERSES); return DHAMMAPADA_VERSES;
    default: count = 0; return nullptr;
  }
}

// The built-in English line for a European or scripture quote, found by its original text (nullptr: none)
static const char* englishFor(QKind kind, const char* text) {
  if (kind == Q_EUROPE) {
    const EuroQuote* q = europeQuote(text);
    return q ? q->english : nullptr;
  }
  int count;
  const Verse* list = verseList(kind, count);
  for (int i = 0; i < count; i++) if (!strcmp(list[i].text, text)) return list[i].english;
  return nullptr;
}

// Is the quote already in Momowo's language? Then the AI explains it instead of translating it.
static bool quoteInMyLanguage(QKind kind, const char* text = "") {
  if (kind == Q_CHINESE) return LANG == L_ZHS || LANG == L_ZHT;
  if (kind == Q_MODERN || kind == Q_BIBLE) return LANG == L_EN;   // English quotes
  if (kind >= Q_FAMOUS) return gQuote.lang == LANG;   // whatever language the AI found it in
  if (kind == Q_EUROPE) {                   // English, French, German or Spanish writers
    const EuroQuote* q = europeQuote(text);
    if (!q) return false;
    return (q->lang == EL_ENGLISH && LANG == L_EN) || (q->lang == EL_FRENCH && LANG == L_FR) ||
           (q->lang == EL_GERMAN && LANG == L_DE) || (q->lang == EL_SPANISH && LANG == L_ES);
  }
  return false;                             // Hebrew, Arabic, Pali
}

// Until the AI has translated it (or with no AI), the English line is the translation
static void englishFallback(QKind kind, const char* text, char* meaning, size_t n) {
  const char* en = englishFor(kind, text);
  if (en && (QUOTE_AI == 0 || !AI_API_KEY[0])) utf8Copy(meaning, en, n);
}

// A European, modern or scripture quote in its original language, with its source
static void setWorldQuote(QKind kind, const char* text, const char* who) {
  xSemaphoreTake(gMutex, portMAX_DELAY);
  gQuote.kind = kind;
  utf8Copy(gQuote.text, text, sizeof(gQuote.text));
  snprintf(gQuote.author, sizeof(gQuote.author), "- %s", who);
  gQuote.tag[0] = 0;
  gQuote.meaning[0] = 0;
  gQuote.lang = -1;
  englishFallback(kind, gQuote.text, gQuote.meaning, sizeof(gQuote.meaning));
  gQuote.version++;
  xSemaphoreGive(gMutex);
}

static_assert(T_STARS == 10 && QM_STARS == 1 << T_STARS, "quote moods follow the QTheme order");

// A random quote that suits the theme (any quote when none does, or with no theme), not the last one
static int pickSuited(const uint16_t* moods, int count, QTheme th, int last) {
  int idx[64], n = 0;
  for (int i = 0; i < count && i < 64; i++)
    if (th != T_NONE && (moods[i] >> th & 1) && i != last) idx[n++] = i;
  if (!n)
    for (int i = 0; i < count && i < 64; i++)
      if (i != last || count == 1) idx[n++] = i;
  return idx[esp_random() % n];
}

static bool pickEuropeQuote(QTheme th) {
  static_assert(EUROPE_COUNT <= 64, "pickSuited looks at 64 quotes at most");
  static int last = -1;
  uint16_t moods[EUROPE_COUNT];
  for (int i = 0; i < EUROPE_COUNT; i++) moods[i] = EUROPE_QUOTES[i].moods;
  int i = last = pickSuited(moods, EUROPE_COUNT, th, last);
  setWorldQuote(Q_EUROPE, EUROPE_QUOTES[i].text, EUROPE_QUOTES[i].who);
  return true;
}

// Modern: a built-in quote that suits the moment; ZenQuotes (free, credited in the guide) when
// nothing in particular applies, built-in ones offline
static bool pickModernQuote(QTheme th) {
  if (th == T_NONE && gWifiUp) {
    String body;
    JsonDocument doc;
    if (httpGet("https://zenquotes.io/api/random", body) && !deserializeJson(doc, body)) {
      const char* q = doc[0]["q"] | "";
      const char* a = doc[0]["a"] | "";
      if (q[0] && strlen(q) < 170 && strncmp(q, "Too many requests", 17)) {
        setWorldQuote(Q_MODERN, q, a[0] ? a : "Unknown");
        return true;
      }
    }
  }
  static int last = -1;
  uint16_t moods[MODERN_COUNT];
  for (int i = 0; i < MODERN_COUNT; i++) moods[i] = MODERN_QUOTES[i].moods;
  int i = last = pickSuited(moods, MODERN_COUNT, th, last);
  setWorldQuote(Q_MODERN, MODERN_QUOTES[i].text, MODERN_QUOTES[i].who);
  return true;
}

// Online: a web quote for the theme; offline (or if the web doesn't answer): built-in.
// European and modern quotes follow the owner's choice on the phone page ("a mix" takes turns).
static bool pickVerse(QKind kind, QTheme th) {
  int count;
  const Verse* list = verseList(kind, count);
  static int last[Q_KINDS] = {-1, -1, -1, -1, -1, -1, -1, -1};
  uint16_t moods[64];
  for (int i = 0; i < count && i < 64; i++) moods[i] = list[i].moods;
  int i = last[kind] = pickSuited(moods, count, th, last[kind]);
  setWorldQuote(kind, list[i].text, list[i].ref);
  return true;
}

// Famous people: Claude picks a real quote by one of the people the owner named, to suit
// the moment, with its translation (or explanation) in the same reply. Needs a key.
static const char* const THEME_EN[] = {"spring", "summer", "autumn", "winter", "a rainy day", "a snowy day",
  "a cloudy day", "a windy day", "a sunny day", "a moonlit night", "a starry night", "any moment"};
static const char* const LANG_CODE[L_COUNT] = {"en", "zh", "zh", "id", "de", "fr", "ja", "es"};

// People of serious public concern (the owner's request): never quoted, and never the voice of the
// news. Common spellings in Momowo's languages; the AI judges anyone not listed.
static const char* const CONCERN_NAMES[] = {
  "hitler", "希特勒", "ヒトラー", "bin laden", "本拉登", "本·拉登", "賓拉登", "賓·拉登", "ビンラディン",
  "ビン・ラディン", "pol pot", "波尔布特", "波爾布特", "ポル・ポト", "himmler", "goebbels", "eichmann",
  "mengele", "baghdadi", "zawahiri", "charles manson", "ted bundy", "breivik", "mcveigh", "asahara",
  "麻原彰晃", "idi amin", "noordin", "imam samudra", "amrozi"};
static const char* const CONCERN_RULE =
  "a real person of serious public concern: a terrorist; an architect or perpetrator of genocide, war crimes, "
  "mass murder or other atrocities; a dictator known chiefly for such crimes; a notorious violent criminal such "
  "as a serial killer or mass shooter; or a leader of a violent hate group. Characters from films, TV, books or "
  "games are fine, villains included, unless the character portrays such a real person";

static bool concernByName(const char* s) {
  char low[128];
  size_t i = 0;
  for (; s[i] && i + 1 < sizeof(low); i++) low[i] = (s[i] >= 'A' && s[i] <= 'Z') ? s[i] + 32 : s[i];
  low[i] = 0;
  for (const char* n : CONCERN_NAMES) if (strstr(low, n)) return true;
  return false;
}

static bool screenCanShow(const char* s) {  // only scripts Momowo has letters for
  const uint8_t* p = (const uint8_t*)s;
  while (*p) {
    uint32_t c = utf8Next(p);
    if (c < 0x250 || (c >= 0x370 && c <= 0x3FF) || (c >= 0x590 && c <= 0x6FF) || (c >= 0x1E00 && c <= 0x1EFF) ||
        (c >= 0x2000 && c <= 0x206F) || (c >= 0x3000 && c <= 0x30FF) || (c >= 0x4E00 && c <= 0x9FFF) ||
        (c >= 0xFF00 && c <= 0xFFEF)) continue;
    return false;
  }
  return true;
}

static bool fetchFamousQuote(QTheme th) {
  const char* names = FAMOUS_PEOPLE;
  if (!names[0] || !AI_API_KEY[0] || !gWifiUp) return false;
  static char recent[4][48];                // not the same few quotes again and again
  static uint8_t rn = 0;
  const char* lim = langIsCjk() ? (LANG == L_JA ? "60 characters" : "45 characters") : "35 words";
  String p = "Pick one real, well-documented quote by one of these people (the owner's favourites): ";
  p += names;
  p += ". Vary the person and the quote. Prefer one that suits ";
  p += THEME_EN[th < T_NONE ? th : T_NONE];
  p += ". Give it exactly as they said or wrote it, at most 30 words (60 characters in Chinese or Japanese). "
       "Never use song lyrics. Never quote ";
  p += CONCERN_RULE;
  p += ". If a name is one, quietly pick another person from the list, or a well-known inspiring figure "
       "if no one else is left.";
  p += " Use its original language if that is English, Chinese, Japanese, Indonesian, Malay, German, French, "
       "Spanish, Italian, Portuguese, Dutch, Greek, Hebrew or Arabic; otherwise use a well-known English "
       "translation. Never invent or misattribute anything: if you are not sure of one, choose another you are sure of.";
  bool any = false;
  for (auto& r : recent) {
    if (!r[0]) continue;
    p += any ? ", \"" : " Not these recent ones: \"";
    p += r;
    p += "\"";
    any = true;
  }
  if (any) p += ".";
  p += " Reply with JSON only: {\"q\":\"the ";
  p += "quote\",\"who\":\"the person's name as usually written in ";
  p += LANG_NAME[LANG];
  p += "\",";
  p += "\"lang\":\"two-letter code of its language\",\"m\":\"";
  if (QUOTE_AI) {
    p += "in "; p += LANG_NAME[LANG]; p += ", at most "; p += lim;
    p += ", what it means and how it could lift someone feeling stressed today; warm and simple, never preachy";
  } else {
    p += "if it is already in "; p += LANG_NAME[LANG]; p += ", a short explanation in that language of what it means, at most ";
    p += lim; p += "; otherwise its faithful translation into natural "; p += LANG_NAME[LANG];
  }
  p += "\"}";
  if (QUOTE_AI) p += genderNote();
  char out[900];
  if (!askAI(p.c_str(), out, sizeof(out), 400, true)) return false;
  char* a = strchr(out, '{');
  char* b = strrchr(out, '}');
  if (!a || !b || b < a) return false;
  b[1] = 0;
  JsonDocument doc;
  if (deserializeJson(doc, a)) return false;
  const char* q = doc["q"] | "";
  const char* who = doc["who"] | "";
  const char* code = doc["lang"] | "";
  const char* m = doc["m"] | "";
  if (!q[0] || strlen(q) > 240 || isRefusal(q) || !screenCanShow(q)) {
    Serial.println("[ai] quote: not usable, a built-in one instead");
    return false;
  }
  char srcFit[88];
  utf8Copy(srcFit, who[0] ? who : "?", sizeof(srcFit));
  int8_t ql = -1;
  for (int i = 0; i < L_COUNT; i++) if (!strncasecmp(code, LANG_CODE[i], 2)) { ql = i; break; }
  if (ql == L_ZHS && LANG == L_ZHT) ql = L_ZHT;   // Chinese either way
  setWorldQuote(Q_FAMOUS, q, srcFit);
  char mm[320] = "";
  if (m[0] && !isRefusal(m) && screenCanShow(m)) {
    utf8Copy(mm, m, sizeof(mm));
    clampText(mm, langIsCjk() ? 300 : 260);
  }
  xSemaphoreTake(gMutex, portMAX_DELAY);
  gQuote.lang = ql;
  strlcpy(gQuote.meaning, mm, sizeof(gQuote.meaning));
  gQuote.version++;
  xSemaphoreGive(gMutex);
  utf8Copy(recent[rn], q, sizeof(recent[0]));
  rn = (rn + 1) % 4;
  return true;
}

static bool fetchQuote(QTheme th) {
  static uint8_t turn = Q_KINDS - 1;        // take turns through the chosen sources
  uint16_t mask = QUOTE_MASK ? QUOTE_MASK : 1;
  for (int i = 0; i < Q_KINDS; i++) {
    turn = (turn + 1) % Q_KINDS;
    if (mask >> turn & 1) break;
  }
  if (turn == Q_EUROPE) return pickEuropeQuote(th);   // every source follows the moment's theme
  if (turn == Q_MODERN) return pickModernQuote(th);
  if (turn == Q_FAMOUS) return fetchFamousQuote(th) || pickModernQuote(th);   // no key: modern
  if (turn != Q_CHINESE) return pickVerse((QKind)turn, th);
  if (gWifiUp) {
    if (th != T_NONE && fetchJinrishici(THEME_PATH[th], THEME_TAG[th], 8)) return true;
    if (fetchHitokotoClassical()) return true;
    if (fetchJinrishici("all", "", 5)) return true;
  }
  return pickLocalQuote(th);
}

// ---- Quote context: season (hemisphere-aware), weather, time of day ----
static QTheme seasonTheme(int month, float lat) {         // month 1-12
  if (lat < 0) month = (month + 5) % 12 + 1;              // southern hemisphere: six months on
  if (month >= 3 && month <= 5)  return T_SPRING;
  if (month >= 6 && month <= 8)  return T_SUMMER;
  if (month >= 9 && month <= 11) return T_AUTUMN;
  return T_WINTER;
}

static QTheme weatherTheme(const WeatherData& w) {
  if (!w.valid) return T_NONE;
  int c = w.code;
  if ((c >= 51 && c <= 67) || (c >= 80 && c <= 82) || c >= 95) return T_RAIN;
  if ((c >= 71 && c <= 77) || c == 85 || c == 86) return T_SNOW;
  if (c == 3 || c == 45 || c == 48) return T_CLOUD;
  if (w.wind >= 30) return T_WIND;
  return T_NONE;
}

static int timeBucket(int h) {                            // 0 night, 1 dawn, 2 day, 3 dusk
  if (h >= 20 || h < 5) return 0;
  if (h < 9) return 1;
  if (h < 17) return 2;
  return 3;
}

static QTheme timeTheme(int h, const WeatherData& w) {
  bool clear = w.valid && w.code <= 2;
  switch (timeBucket(h)) {
    case 0:  return (clear && (esp_random() & 1)) ? T_STARS : T_MOON;
    case 2:  return clear ? T_SUN : T_NONE;
    default: return T_SUN;                                // sunrise, sunset
  }
}

// Weighted pick: weather 3, time of day 2, season 2 (only themes that apply)
static QTheme pickTheme(QTheme season, QTheme wx, QTheme tod) {
  uint32_t ww = wx != T_NONE ? 3 : 0, wt = tod != T_NONE ? 2 : 0, ws = season != T_NONE ? 2 : 0;
  if (ww + wt + ws == 0) return T_NONE;                   // nothing applies: any classical quote
  uint32_t r = esp_random() % (ww + wt + ws);
  if (r < ww) return wx;
  if (r < ww + wt) return tod;
  return season;
}

// Scan, then join home WiFi if it's in range, otherwise the backup network
// WiFi failure reasons in plain words (ESP-IDF wifi_err_reason_t codes)
static const char* wifiReasonText(uint8_t r) {
  switch (r) {
    case 0:   return nullptr;
    case 2: case 15: case 202: case 204:  return T(S_WR_PASS);
    case 201: case 210: case 211: case 212: return T(S_WR_NOTFOUND);   // also 5 GHz-only networks
    case 200: return T(S_WR_LOST);
    default:  return T(S_WR_CANT);
  }
}

static void onWiFiEvent(arduino_event_id_t e, arduino_event_info_t info) {
  if (e == ARDUINO_EVENT_WIFI_STA_DISCONNECTED) {
    uint8_t r = info.wifi_sta_disconnected.reason;
    if (r != 8) gWifiReason = r;            // 8 = we disconnected on purpose: not a failure
  } else if (e == ARDUINO_EVENT_WIFI_STA_GOT_IP) {
    gWifiReason = 0;
  }
}

static uint8_t gHomeFails = 0;              // home WiFi seen but refused us this many times in a row
static volatile bool gPlannedHop = false;   // leaving the backup to try home: no sad sound
static bool connectWiFi() {
  WiFi.disconnect();
  xSemaphoreTake(gScanMutex, portMAX_DELAY);
  int n = WiFi.scanNetworks();
  int home = -1, hot = -1;
  for (int i = 0; i < n; i++) {
    String ssid = WiFi.SSID(i);
    if (WIFI_SSID[0] && ssid == WIFI_SSID) {
      if (home < 0 || WiFi.RSSI(i) > WiFi.RSSI(home)) home = i;
    } else if (WIFI2_SSID[0] && ssid == WIFI2_SSID) {
      if (hot < 0 || WiFi.RSSI(i) > WiFi.RSSI(hot)) hot = i;
    }
  }
  int pick = (home >= 0 && !(hot >= 0 && gHomeFails >= 2)) ? home : hot;   // after 2 refusals: the backup
  if (pick >= 0) {
    gOnHotspot = (pick == hot);
    // channel + BSSID from the scan skip a second search and connect faster
    WiFi.begin(WiFi.SSID(pick).c_str(), gOnHotspot ? WIFI2_PASS : WIFI_PASS,
               WiFi.channel(pick), WiFi.BSSID(pick));
#if CONFIG_IDF_TARGET_ESP32C3
    WiFi.setTxPower(WIFI_POWER_8_5dBm);   // C3 SuperMini antenna quirk: full power often fails
#endif
  }
  WiFi.scanDelete();
  xSemaphoreGive(gScanMutex);
  if (pick < 0) {                           // not seen in the scan (hidden, weak, or a missed
    gOnHotspot = false;                     // scan): try joining it by name anyway
    Serial.printf("[wifi] \"%s\" not in scan, trying directly\n", WIFI_SSID);
    WiFi.begin(WIFI_SSID, WIFI_PASS);
#if CONFIG_IDF_TARGET_ESP32C3
    WiFi.setTxPower(WIFI_POWER_8_5dBm);
#endif
  } else {
    Serial.printf("[wifi] joining \"%s\"\n", gOnHotspot ? WIFI2_SSID : WIFI_SSID);
  }
  for (int i = 0; i < 60 && WiFi.status() != WL_CONNECTED; i++)
    vTaskDelay(pdMS_TO_TICKS(250));
  gPlannedHop = false;
  if (WiFi.status() == WL_CONNECTED) {
    Serial.printf("[wifi] connected, IP %s\n", WiFi.localIP().toString().c_str());
    if (!gOnHotspot) gHomeFails = 0;
    return true;
  }
  if (!gOnHotspot) {                        // count real refusals only, not a network that wasn't there
    if (pick >= 0) gHomeFails = gHomeFails < 250 ? gHomeFails + 1 : 250;
  } else {
    gHomeFails = 0;                         // backup failed too: try home again next time
  }
  const char* why = wifiReasonText(gWifiReason);
  Serial.printf("[wifi] failed: %s (reason %u)\n", why ? why : "timed out", gWifiReason);
  return false;
}

static bool homeInRange() {
  if (!WIFI_SSID[0]) return false;
  xSemaphoreTake(gScanMutex, portMAX_DELAY);
  int n = WiFi.scanNetworks();
  bool found = false;
  for (int i = 0; i < n && !found; i++) found = (WiFi.SSID(i) == WIFI_SSID);
  WiFi.scanDelete();
  xSemaphoreGive(gScanMutex);
  return found;
}

// Tidy one RSS title: strip CDATA, decode entities, make it plain ASCII
static void cleanTitle(const char* in, char* out, size_t n) {
  const char* p = in;
  char body[160];
  const char* cd = strstr(p, "<![CDATA[");
  if (cd) {
    strlcpy(body, cd + 9, sizeof(body));
    char* e = strstr(body, "]]>");
    if (e) *e = 0;
    p = body;
  }
  char tmp[200];
  size_t o = 0;
  while (*p && o + 4 < sizeof(tmp)) {
    if (*p == '&') {
      if (!strncmp(p, "&amp;", 5))  { tmp[o++] = '&';  p += 5; continue; }
      if (!strncmp(p, "&lt;", 4))   { tmp[o++] = '<';  p += 4; continue; }
      if (!strncmp(p, "&gt;", 4))   { tmp[o++] = '>';  p += 4; continue; }
      if (!strncmp(p, "&quot;", 6)) { tmp[o++] = '"';  p += 6; continue; }
      if (!strncmp(p, "&apos;", 6)) { tmp[o++] = '\''; p += 6; continue; }
      if (p[1] == '#') {                    // numeric entity -> UTF-8, then asciiize() tidies it
        char* end;
        long v = (p[2] == 'x' || p[2] == 'X') ? strtol(p + 3, &end, 16) : strtol(p + 2, &end, 10);
        if (*end == ';' && v > 0 && v < 0x10000) {
          if (v < 0x80) tmp[o++] = (char)v;
          else if (v < 0x800) { tmp[o++] = (char)(0xC0 | (v >> 6)); tmp[o++] = (char)(0x80 | (v & 0x3F)); }
          else { tmp[o++] = (char)(0xE0 | (v >> 12)); tmp[o++] = (char)(0x80 | ((v >> 6) & 0x3F)); tmp[o++] = (char)(0x80 | (v & 0x3F)); }
          p = end + 1;
          continue;
        }
      }
    }
    tmp[o++] = *p++;
  }
  tmp[o] = 0;
  utf8Copy(out, tmp, n);                    // UTF-8 kept, so other languages' headlines survive
  char* q = out;                            // trim
  while (*q == ' ') q++;
  if (q != out) memmove(out, q, strlen(q) + 1);
  for (int i = (int)strlen(out) - 1; i >= 0 && out[i] == ' '; i--) out[i] = 0;
}
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
void loop() {
  uint32_t now = millis();

  gLoopNow = now;                           // handlers time things on loop()'s clock, not a later one
  server.handleClient();                    // phone settings page
  gameTick(now);                            // mini-games played from the phone
  if (gSetupMode) dnsServer.processNextRequest();
  // HTTP/game handlers can yield while netTask updates its heartbeat. Snapshot the
  // heartbeat BEFORE reading the clock, not against loop()'s earlier timestamp.
  // Signed elapsed time also tolerates the heartbeat's millis() | 1 sentinel
  // being one millisecond ahead, without wrapping into a false 45-minute stall.
  const uint32_t netAlive = gNetAlive;
  const int32_t netIdleMs = (int32_t)(millis() - netAlive);
  if (!gRestartAt && netAlive && netIdleMs > 45L * 60 * 1000) {   // the network task is stuck
    Serial.println("[net] no pass for 45 min: restarting");
    gRestartAt = now;
  }
  if (!gRestartAt && gRestartSoon && (!gDisplayOn || (now - gLastInteraction > 30UL * 60 * 1000 &&
      fState == F_IDLE && !gameActive(now) && !gSetupMode)) && gAlarm.state == AL_IDLE && !gAlarm.napUntil) {
    Serial.println("[mem] fragmented: restarting while nobody's looking");
    gRestartAt = now;
  }
  if (gRestartAt && (int32_t)(now - gRestartAt) >= 0) {
    if (time(nullptr) > 1700000000) prefs.putULong("epoch", (uint32_t)time(nullptr));   // keep the clock
    ESP.restart();
  }
  // Setup closes by itself after 10 minutes without a phone on it; never opens by itself
  if (gSetupMode && WiFi.softAPgetStationNum() == 0 && now - gSetupAt > 10UL * 60 * 1000) stopSetupMode();

  static uint32_t tzApplied = 0xFFFFFFFF;   // apply timezone changes on this core
  static uint32_t tzCheckAt = 0;             // and every 2 s: summer time by the zone rule
  if (gTzVersion != tzApplied || now - tzCheckAt >= 2000) {
    const bool force = gTzVersion != tzApplied;
    tzApplied = gTzVersion;
    tzCheckAt = now;
    applyTimezone(force);
  }

  static uint32_t feelSeen = 0;             // a new feeling: show it on the face, say it once
  if (gFeel.version != feelSeen) {
    feelSeen = gFeel.version;
    if (!gSetupMode && !gSleeping && xSemaphoreTake(gMutex, pdMS_TO_TICKS(20)) == pdTRUE) {
      char said[sizeof(gFeel.thought)];
      strlcpy(said, gFeel.thought, sizeof(said));
      Mood m = gFeel.mood;
      xSemaphoreGive(gMutex);
      if (m != M_NORMAL) setMood(m, 6000);
      announce(said, 15000);
      PLAY(SND_ON);
    }
  }

  static uint32_t lastCal = 0;              // calendars: cheap, refresh once a second
  if (now - lastCal >= 1000) {
    lastCal = now;
    updateCalendar();
    updatePrayers();
    struct tm pt;
    if (nowTm(pt)) prayerReminder(pt);
  }

  struct tm t;
  bool tv = nowTm(t);
  gNight = tv && isNightHour(t.tm_hour);
  static uint32_t lastRtcSave = 0;          // clock chip: keep it matched to internet time
  if (gRtc && gWifiUp && tv && (lastRtcSave == 0 || now - lastRtcSave > 3600000UL)) { lastRtcSave = now; rtcSave(); }
  if (tv) {                                 // a new day: start counting again (but a restart on the
    int dayKey = (t.tm_year + 1900) * 1000 + t.tm_yday;   // same day keeps the saved count)
    if (dayKey != gSessionDay) {
      gSessionDay = dayKey;
      gSessions = 0;
      gPatsToday = 0;
      gShakesToday = gBreathsToday = 0;
      prefs.putInt("fday", dayKey);
      prefs.putInt("fdone", 0);
      prefs.putInt("mp_n", 0);
    }
  }

  Gesture g = readGesture(now);
  if (g != G_NONE) { gLastTouch = now; handleGesture(g, now); }
  alarmTick(now);                           // after the touch: it watches the pad being held

  static uint32_t lastMotion = 0;           // MPU6050: about 50 readings a second
  static uint32_t lastMpuTry = 0;           // not found at boot: keep looking (a loose wire)
  if (!gMotion && now - lastMpuTry >= 5000) {
    lastMpuTry = now;
    if ((gMotion = motion::mpuBegin())) Serial.println("[motion] MPU6050 found");
  }
  const bool rollOn = gGame.game == GM_ROLL && gameActive(now);
  const bool questOn = gGame.game == GM_QUEST && gameActive(now);
  if (digitalRead(TOUCH_PIN) == HIGH) gLastTouch = now;   // a finger on the pad: its bump is not a pat
  if (gMotion && now - lastMotion >= 20) {  // always read, so the games know which way is down
    lastMotion = now;
    float a[3], gy[3];
    if (motion::mpuRead(a, gy)) {
      motion::Event ev = motion::update(gMs, a, gy, now, MOTION_SENS);
      if (gAlarm.state == AL_RING) { if (ev != motion::EV_NONE) alarmMotion(ev, now); }
      else if (questOn) { if (ev == motion::EV_SHAKE) questInput(QA_SHAKE, now); }
      else if (ev != motion::EV_NONE && MOTION_ON && !gSetupMode && !rollOn) handleMotion(ev, now);
    }
  }

  focusUpdate(now);

  static uint32_t lastSweep = 0;
  if (now - lastSweep >= 1000) { lastSweep = now; sweepTimers(now); }
  bool sleeping = gNight && !notYet(now, gNightAwakeUntil) && fState != F_RUN && fState != F_BREATHE && !gSetupMode &&
                  gAlarm.state != AL_RING;
  const bool idle = !sleeping && !gSetupMode && fState == F_IDLE && !gameActive(now) && gAlarm.state != AL_RING &&
                    now - gLastInteraction > 20UL * 60 * 1000;
  static uint8_t contrast = CONTRAST_DAY;
  const uint8_t wantContrast = gSetupMode ? CONTRAST_QR : sleeping ? CONTRAST_NIGHT : idle ? CONTRAST_IDLE : CONTRAST_DAY;
  if (wantContrast != contrast) { contrast = wantContrast; display.setContrast(contrast); }
  if (sleeping != gSleeping) {
    gSleeping = sleeping;
    if (!sleeping) {
      setMood(M_SURPRISED, 700);             // waking up
      if (!gNight) PLAY(SND_WAKE);           // the real morning, not a night-time touch
    }
  }

  // Hourly chime (checked once a second)
  static uint32_t lastSoundCheck = 0;
  static int lastChimeHour = -1;
  if (tv && now - lastSoundCheck >= 1000) {
    lastSoundCheck = now;
    if (HOURLY_CHIME && t.tm_min == 0 && t.tm_hour != lastChimeHour && !gNight && fState != F_RUN &&
        t.tm_hour != WAKE_HOUR) {             // wake-up hour has its morning tune instead
      lastChimeHour = t.tm_hour;
      PLAY(SND_HOUR);
    }
  }
  static int airBand = 0;                   // the air got worse (above 100, 150, 200): Momowo coughs
  const int aqi = getWeather().aqi;
  const int band = aqi > 200 ? 3 : aqi > 150 ? 2 : aqi > 100 ? 1 : 0;
  if (band > airBand && aqi >= 0) {
    setMood(M_SAD, 4000);
    announce(T(S_AQI_COUGH), 7000);
    PLAY(SND_COUGH);
  }
  if (aqi >= 0) airBand = band;
  static bool wasOnline = false;            // WiFi lost: a sad little sound
  if (wasOnline && !gWifiUp && !gPlannedHop) PLAY(SND_SAD);
  wasOnline = gWifiUp;
  if (sleeping && gDisplayOn && now - gLastInteraction > NIGHT_OFF_MS) {
    display.oled_command(SH110X_DISPLAYOFF);
    gDisplayOn = false;
  }
  if (!gDisplayOn && !sleeping) {
    display.oled_command(SH110X_DISPLAYON);
    gDisplayOn = true;
  }

  if (gPage != P_BUDDY && now - gLastInteraction > IDLE_HOME_MS && fState != F_BREATHE) {
    gPage = P_BUDDY;
    gPageEnter = now;
  }

  static uint32_t lastFrame = 0;
  if (gDisplayOn && now - lastFrame >= FRAME_MS) {
    lastFrame = now;
    render(now, sleeping);
  }
  delay(2);
}
