jjah0001/Momowo/(commit log)

2026-10-25 Initial upload of Momowo firmware, guides and enclosure
    Claude-Session: https://claude.ai/code/session_01PoBjjeuLhade57PwxrGk8G
    [Momowo_Backside.f3d, Momowo_Backside.step, Momowo_Backside.stl, Momowo_Front.f3d, Momowo_Front.step, Momowo_Front.stl]
2026-11-03 Add Songs page with AI song picks and Spotify playlist
    Momowo suggests a song (title and artist only, never lyrics) to suit the
    owner's music taste and the moment. Optional Spotify app keys let Spotify
    check each pick and give play links; without an AI key Momowo picks from
    Spotify itself. Linking the owner's Spotify account keeps a private
    "Momowo picks" playlist, with a fill-10-songs button on the phone page.
    Labels in all 8 languages; User Guide updated. Also brings the repo copy up
    to the latest firmware (boot fix, Europe quotes, QR contrast).
    Claude-Session: https://claude.ai/code/session_01FvpSvGkNRnRg6RPUZKEgqL
    [Momowo_V2.ino, lang.h, portal.h, quotes.h]
2026-11-03 Flip tilt direction for in-case sensor orientation; rebuild merged firmware
    [Momowo_V2.ino]
2026-11-03 Songs: learn the owner's taste from their Spotify listening
    Once a day Momowo reads the owner's own playlists, top artists and recently
    played songs (titles and artists only), counts the artists they play most,
    and gives that to the AI so it suggests songs they would likely love but
    don't have yet. Spotify-only picks search those artists too. The typed music
    taste becomes optional. Phone page: learn switch, what was learned, and a
    Learn now button, in all 8 languages; User Guide updated.
    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
2026-11-04 Remove the Songs page and Spotify settings
    Jeffrey asked to remove the song recommendation page altogether. Firmware,
    screen labels, phone setup page and User Guide go back to how they were
    before it; the quest tilt fix and the root-level sketch layout stay.
    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
    [Momowo_V2.ino, lang.h, portal.h]
2026-11-05 Add a wake-up alarm, snooze and nap timer with an original melody
    - Up to three alarms set on the phone page, each on chosen weekdays or once
    - "Momowo Morning": an original hummable tune that starts soft and grows
    in three levels (PWM duty, tempo, extra phrase); rings even when muted,
    at night and during focus
    - Tap or bump to snooze; hold the pad 2 s (or shake 3 times) to stop;
    good-morning greeting with the day's weather afterwards
    - New Alarm page: next alarm and countdown, hold to switch alarms on/off,
    2 s hold for a nap timer
    - Labels in all eight languages, User Guide updated, merged .bin rebuilt
    Claude-Session: https://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
